robmacl/breathecam/Parts Lists/Arecont/benedum mount.xlsx

1 | 89015K243 (http://www.mcmaster.com/nav/enter.asp?partnum=89015K243) | Multipurpose 6061 Aluminum, Sheet, .125" Thick, 18" X 18" | 1 | 1 | 0 | 56.67 | 56.67
 |  |  | Each |  |  | Each
2 | 8975K142 (http://www.mcmaster.com/nav/enter.asp?partnum=8975K142) | Multipurpose 6061 Aluminum, 1/4" Thick, 12" X 12" | 1 | 1 | 0 | 30.39 | 30.39
 |  |  | Each |  |  | Each
3 | 8982K14 (http://www.mcmaster.com/nav/enter.asp?partnum=8982K14) | Multipurpose 6061 Aluminum, 90 Degree Angle, 1/8" Thick, 2" X 2" Legs, 1' Long | 1 | 1 | 0 | 6.17 | 6.17
 |  |  | Each |  |  | Each
4 | 93190A546 (http://www.mcmaster.com/nav/enter.asp?partnum=93190A546) | Type 316 Stainless Steel Hex Head Cap Screw, 1/4"-20 Thread, 1-1/2" Long, Fully Threaded, Packs of 10 | 1 | 1 | 0 | 5.27 | 5.27
 |  |  | Pack |  |  | Per Pack
5 | 91831A029 (http://www.mcmaster.com/nav/enter.asp?partnum=91831A029) | 18-8 Stainless Steel Nylon-Insert Hex Locknut, 1/4"-20 Thread Size, 7/16" Width, 5/16" Height, Packs of 50 | 1 | 1 | 0 | 4.3 | 4.3
 |  |  | Pack |  |  | Per Pack
6 | 92141A029 (http://www.mcmaster.com/nav/enter.asp?partnum=92141A029) | 18-8 Stainless Steel General Purpose Flat Washer, 1/4" Screw Size, 5/8" OD, .04"-.06" Thick, Packs of 100 | 1 | 1 | 0 | 3.37 | 3.37
 |  |  | Pack |  |  | Per Pack
7 | 97517A330 (http://www.mcmaster.com/nav/enter.asp?partnum=97517A330) | Aluminum Blind Rivet with Steel Mandrel, Wide Domed, 3/16" Diameter, .251"-.375" Material Thickness, Packs of 100 | 1 | 1 | 0 | 7.38 | 7.38
 |  |  | Pack |  |  | Per Pack
8 | 7649K52 (http://www.mcmaster.com/nav/enter.asp?partnum=7649K52) | Rain-Tight Outdoor Steel Enclosure (NEMA 3R), with Knockouts and Lift-Off Cover, 8" H, 8" W, 4" D | 1 | 1 | 0 | 28.62 | 28.62
 |  |  | Each |  |  | Each
9 | 7609K4 (http://www.mcmaster.com/nav/enter.asp?partnum=7609K4) | Liquid-Tight Ultra-Flex Plastic Conduit, 3/4 Trade Size, 0.83" ID, 1.04" OD, 5' Length | 5 | 5 | 0 | 2.23 | 11.15
 |  |  | Feet |  |  | Per Foot
10 | 88805K77 (http://www.mcmaster.com/nav/enter.asp?partnum=88805K77) | Highly Corrosion-Resistant 6063 Aluminum, 90 Degree Angle, 1/8" Thick, 1" X 1" Legs, 4' Long | 1 | 1 | 0 | 12.21 | 12.21
 |  |  | Each |  |  | Each
11 | 8975K578 (http://www.mcmaster.com/nav/enter.asp?partnum=8975K578) | Multipurpose 6061 Aluminum, Rectangular Bar, 1/8" X 1", 1/2' Long | 4 | 4 | 0 | 0.91 | 3.64
 |  |  | Each |  |  | Each
12 | 71695K21 (http://www.mcmaster.com/nav/enter.asp?partnum=71695K21) | Steel Switch Box, 2-1/8" X 4" X 1-7/8" | 1 | 1 | 0 | 1.86 | 1.86
 |  |  | Each |  |  | Each
13 | 71695K23 (http://www.mcmaster.com/nav/enter.asp?partnum=71695K23) | Duplex Receptacle Cover for Switch Box, Steel | 1 | 1 | 0 | 0.68 | 0.68
 |  |  | Each |  |  | Each
14 | 7159K3 (http://www.mcmaster.com/nav/enter.asp?partnum=7159K3) | Straight-Blade Receptacle, Economy, NEMA 5-15, Gray | 1 | 1 | 0 | 2.13 | 2.13
 |  |  | Each |  |  | Each
15 | 7798K41 (http://www.mcmaster.com/nav/enter.asp?partnum=7798K41) | Cord Grip for Building Cable, Screw Connector Style, 1/2 Trade Size | 1 | 1 | 0 | 0.98 | 0.98
 |  |  | Each |  |  | Each
16 | 29115A724 (http://www.mcmaster.com/nav/enter.asp?partnum=29115A724) | Long-Life Tin-Coated High-Speed-Steel Jobbers' Drill Bit, 1/4", 4" L Overall, 2.4" Drill Depth, 135 Degree Point | 1 | 1 | 0 | 4.95 | 4.95
 |  |  | Each |  |  | Each
 | Adafruit
1 x Cable Gland - Waterproof RJ-45 / Ethernet connector (RJ-45) [ID:827] =
$7.95
