robmacl/breathecam/Parts Lists/Arecont/TimeMachineIPMount.xlsx

1 | 92210A546 (http://www.mcmaster.com/nav/enter.asp?partnum=92210A546) | 18-8 Stainless Steel Flat Head Socket Cap Screw, 1/4"-20 Thread, 1-1/2" Long, packs of 25 | 2 | today | 7.04 | 14.08
 |  |  | packs |  | per pack
2 | 91831A029 (http://www.mcmaster.com/nav/enter.asp?partnum=91831A029) | 18-8 Stainless Steel Nylon-Insert Hex Locknut, 1/4"-20 Thread Size, 7/16" Width, 5/16" Height, packs of 50 | 1 | today | 5.01 | 5.01
 |  |  | pack |  | per pack
3 | 95584A207 (http://www.mcmaster.com/nav/enter.asp?partnum=95584A207) | 18-8 Stainless Steel External-Tooth Lock Washer, 1/4" Screw Size, 0.51" OD, 0.02"-0.03" Thick, packs of 100 | 1 | today | 3.88 | 3.88
 |  |  | pack |  | per pack
4 | 95584A205 (http://www.mcmaster.com/nav/enter.asp?partnum=95584A205) | 18-8 Stainless Steel External-Tooth Lock Washer, No. 10 Screw Size, 0.41" OD, 0.01"-0.03" Thick, packs of 100 | 1 | today | 2.77 | 2.77
 |  |  | pack |  | per pack
5 | 91772A247 (http://www.mcmaster.com/nav/enter.asp?partnum=91772A247) | 18-8 Stainless Steel Pan Head Phillips Machine Screw, 10-24 Thread, 1" Length, packs of 50 | 1 | today | 7.28 | 7.28
 |  |  | pack |  | per pack
6 | 91831A011 (http://www.mcmaster.com/nav/enter.asp?partnum=91831A011) | 18-8 Stainless Steel Nylon-Insert Hex Locknut, 10-24 Thread Size, 3/8" Width, 15/64" Height, packs of 100 | 1 | today | 6.54 | 6.54
 |  |  | pack |  | per pack
7 | 96659A104 (http://www.mcmaster.com/nav/enter.asp?partnum=96659A104) | 18-8 Stainless Steel Type A SAE Flat Washer, No. 10 Screw Size, 1/2" OD, .03"-.07" Thick, packs of 100 | 1 | today | 4.48 | 4.48
 |  |  | pack |  | per pack
8 | 2742A514 (http://www.mcmaster.com/nav/enter.asp?partnum=2742A514) | Countersink for Aluminum, Brass, and Bronze, 3-Flute, 82 Degree Angle, 5/8" Body Diameter, 1/4" Shank Diameter | 1 | today | 21.32 | 21.32
 |  |  | each |  | each
9 | 7438K32 (http://www.mcmaster.com/nav/enter.asp?partnum=7438K32) | Outdoor Extension Cord, 16 Gauge Wire, Orange, 25' Long | 1 | today | 13.24 | 13.24
 |  |  | each |  | each
10 | 69915K53 (http://www.mcmaster.com/nav/enter.asp?partnum=69915K53) | Nylon Liquid-Tight Cord Grip (NEMA 6), Straight Standard, 1/2" NPT, .24"-.47" Cord Diameter | 2 | today | 3.24 | 6.48
 |  |  | each |  | each
11 | 69915K54 (http://www.mcmaster.com/nav/enter.asp?partnum=69915K54) | Nylon Liquid-Tight Cord Grip (NEMA 6), Straight Standard, 1/2" NPT, .20"-.35" Cord Diameter | 2 | today | 3.24 | 6.48
 |  |  | each |  | each
12 | 69915K57 (http://www.mcmaster.com/nav/enter.asp?partnum=69915K57) | Nylon Liquid-Tight Cord Grip (NEMA 6), Straight Standard, 1/2" NPT, .39"-.56" Cord Diameter | 2 | today | 3.46 | 6.92
 |  |  | each |  | each
13 | 7160K73 (http://www.mcmaster.com/nav/enter.asp?partnum=7160K73) | GFCI Receptacle, Box Mount, NEMA 5-15, White | 1 | today | 15.04 | 15.04
 |  |  | each |  | each
14 | 2779K12 (http://www.mcmaster.com/nav/enter.asp?partnum=2779K12) | LED Panel Mount Indicating Light, 8MM, 12V AC/DC, Sunlight Visible/Waterproof, Green | 1 | today | 14.52 | 14.52
 |  |  | each |  | each
15 | 2779K802 (http://www.mcmaster.com/nav/enter.asp?partnum=2779K802) | Push-on Black Connector Lead for, LED Panel Mount Indicating Light | 1 | today | 2.76 | 2.76
 |  |  | each |  | each
16 | 2779K801 (http://www.mcmaster.com/nav/enter.asp?partnum=2779K801) | Push-on Red Connector Lead for, LED Panel Mount Indicating Light | 1 | today | 2.76 | 2.76
 |  |  | each |  | each
17 | 7280K11 (http://www.mcmaster.com/nav/enter.asp?partnum=7280K11) | NPT Threaded Aluminum Hole Plug, 1/2" Thread Size, 3/4" Head Diameter | 5 | today | 2.33 | 11.65
 |  |  | each |  | each
18 | 7566K35 (http://www.mcmaster.com/nav/enter.asp?partnum=7566K35) | Cable Tie Holder, Screw Mount, 4-Way Compact, .18" W Max Tie, #10 Screw Size, packs of 100 | 1 | today | 12.46 | 12.46
 |  |  | pack |  | per pack
19 | 99604A107 (http://www.mcmaster.com/nav/enter.asp?partnum=99604A107) | Silicone Sealing Washer, No. 10 Screw Size, 1/2" OD, .093" Thick, packs of 50 | 1 | today | 9.31 | 9.31
 |  |  | pack |  | per pack
20 | 8104K111 (http://www.mcmaster.com/nav/enter.asp?partnum=8104K111) | Lamp Cable, 18/2 AWG, 0.11" X 0.21" OD, 300 VAC, Black | 20 | today | 0.25 | 5
 |  |  | feet |  | per foot
21 | 7527K42 (http://www.mcmaster.com/nav/enter.asp?partnum=7527K42) | 300 VAC/VDC Terminal Block, 2 Circuits, 3/8" Center-to-Center, 20 Amps | 1 | today | 1.32 | 1.32
 |  |  | each |  | each
22 | 81905K11 (http://www.mcmaster.com/nav/enter.asp?partnum=81905K11) | Pluggable Touch-Safe Terminal Block, Plug, 2 Circuits | 1 | today | 1.18 | 1.18
 |  |  | each |  | each
23 | 81905K21 (http://www.mcmaster.com/nav/enter.asp?partnum=81905K21) | Pluggable Touch-Safe Terminal Block, Receptacle, 2 Circuits | 1 | today | 1.07 | 1.07
 |  |  | each |  | each
24 | 7219K22 (http://www.mcmaster.com/nav/enter.asp?partnum=7219K22) | Aluminum Weatherproof Box, Single Device (1 Gang), Three 1/2 Trade Size Hubs, 2" D | 1 | today | 4.17 | 4.17
 |  |  | each |  | each
25 | 7526K25 (http://www.mcmaster.com/nav/enter.asp?partnum=7526K25) | Nylon Wall Plate, 1 GFCI Receptacle, 2-15/16" W X 4-11/16" H, White | 1 | today
 |  |  | each
 |  | 12v adapter | http://www.amazon.com/dp/B00DGG7E36/ref=pe_385040_30332200_pe_309540_26725410_item
 |  | pelican case | http://www.amazon.com/dp/B0000DYVAV/ref=pe_385040_30332200_pe_309540_26725410_item
 |  | ethernet cable | http://www.amazon.com/dp/B001TH7GVE/ref=pe_385040_30332200_pe_309540_26725410_item
 |  | tripod mount | http://www.bhphotovideo.com/c/product/554165-REG/Manfrotto_410PL_410PL_Quick_Release_Plate.html
1 | 7587A37 (http://www.mcmaster.com/nav/enter.asp?partnum=7587A37) | Dow Corning Silicone Adhesive/Sealant, 732, 3.0 Ounce Tube, Clear | 2 | 2 | 0 | 3.95 | 7.9
 |  |  | Each |  |  | Each
2 | 7219K13 (http://www.mcmaster.com/nav/enter.asp?partnum=7219K13) | Round, Vertical/Horizontal 1 Hole Cover for, Aluminum Weatherproof Box | 2 | 2 | 0 | 2.89 | 5.78
 |  |  | Each |  |  | Each
3 | 7581K42 (http://www.mcmaster.com/nav/enter.asp?partnum=7581K42) | Super Tough Liquid-Tight PVC Conduit, 1/2" Trade Size, 0.63" ID, 0.83" OD, 10' Length | 10 | 10 | 0 | 1.13 | 11.3
 |  |  | Feet |  |  | Per Foot
4 | 9106K42 (http://www.mcmaster.com/nav/enter.asp?partnum=9106K42) | Liquid-Tight Nonmetallic Conduit Fitting, Twist-in Straight, PVC, 1/2" Trade Size, Black | 2 | 2 | 0 | 1.6 | 3.2
 |  |  | Each |  |  | Each
5 | 9106K88 (http://www.mcmaster.com/nav/enter.asp?partnum=9106K88) | Liquid-Tight Nonmetallic Conduit Fitting, Twist-in Coupling, PVC, 1/2" Trade Size | 2 | 2 | 0 | 1.34 | 2.68
 |  |  | Each |  |  | Each
1 | 9246K21 (http://www.mcmaster.com/nav/enter.asp?partnum=9246K21) | Multipurpose Aluminum (Alloy 6061), 3/8" Thick, 8" X 8" | 2 | 2 | 0 | 21.05 | 42.1
 |  |  | Each |  |  | Each
2 | 6546K342 (http://www.mcmaster.com/nav/enter.asp?partnum=6546K342) | Multipurpose Aluminum (Alloy 6061) Rectangle Tube, 3/16" Wall Thickness, 1" X 1", 3' Length | 2 | 2 | 0 | 18.73 | 37.46
 |  |  | Each |  |  | Each
3 | 8975K17 (http://www.mcmaster.com/nav/enter.asp?partnum=8975K17) | Multipurpose Aluminum (Alloy 6061), 1/8" Thick X 1" Width X 6' Length | 1 | 1 | 0 | 6.53 | 6.53
 |  |  | Each |  |  | Each
4 | 7219K7 (http://www.mcmaster.com/nav/enter.asp?partnum=7219K7) | Aluminum Weatherproof Box, Round, Five 1/2 Trade Size Hubs, 1-9/16" DP. | 1 | 1 | 0 | 6.5 | 6.5
 |  |  | Each |  |  | Each
5 | 7219K71 (http://www.mcmaster.com/nav/enter.asp?partnum=7219K71) | Aluminum Weatherproof Box, Round, Five 3/4 Trade Size Hubs, 1-9/16" DP | 1 | 1 | 0 | 8.58 | 8.58
 |  |  | Each |  |  | Each
6 | 7807K33 (http://www.mcmaster.com/nav/enter.asp?partnum=7807K33) | Multicord Nylon Liquid-Tight Cord Grip, 1/2" NPT, for 2 Cords, 0.16"-0.20" Cord Diameter Range | 1 | 1 | 0 | 4.33 | 4.33
 |  |  | Each |  |  | Each
7 | 69915K54 (http://www.mcmaster.com/nav/enter.asp?partnum=69915K54) | Nylon Liquid-Tight Cord Grip (NEMA 6), Straight Standard, 1/2" NPT, .20"-.35" Cord Diameter | 2 | 2 | 0 | 3.24 | 6.48
 |  |  | Each |  |  | Each
 |  | poe adapter | http://www.amazon.com/dp/B004UBUB7C/ref=pe_385040_30332200_pe_309540_26725410_item
 | 191772A196 | 18-8 Stainless Steel Pan Head Phillips Machine Screw, 8-32 Thread, 5/8" Length, packs of 1001
 | 95584A203 | 18-8 Stainless Steel External-Tooth Lock Washer, No. 8 Screw Size, 0.39" OD, 0.01"-0.03" Thick, packs of 1001
 | 1810A31 | Loctite General Anaerobic Adhesive, Threadlocker 220, 0.34 Ounce, 10 ml Bottle1
 | 2198A86 | Glass Surface-Mount Bull's Eye Level, with 2 Centering Circles, 1-7/16" Base Diameter1
 | 7219K25 | Aluminum Weatherproof Box, Two Device (2 Gang), Three 1/2 Trade Size Hubs, 2" D1
 | 69105K67 | Straight-Blade Receptacle, Flush-Mount, NEMA 5-15, White1
 | 7533K84 | Wall Plate, Stainless Steel, 2 GFCI Receptacles, 4-9/16" W X 4-1/2" H1
 |  | tripod | http://www.amazon.com/gp/product/B001B2I9L8/ref=ox_ya_os_product
 |  | tripod head | http://www.amazon.com/gp/product/B000H0338Y/ref=ox_ya_os_product
