robmacl/breathecam/Parts Lists/Arecont/trimont parts.xlsx

18"x18"x0.25" aluminum plate | 1 | 89155K27
u-bolts | 4 | 8896T26
nuts for u-bolts | 4 | 91831A127
rubber padding for u-bolts | 3 | 2614T74
washers for u-bolts | 1 | 93852A104
airport express | 1 | http://www.amazon.com/gp/product/B008ALA2RC/ref=ox_sc_act_title_1?ie=UTF8&psc=1&smid=ATVPDKIKX0DER
airport express bracket | 1 | http://www.amazon.com/Out-Sight-Bracket-White--AirPort-Express/dp/B009MRBKXS?s=electronics
3v power cupply | 1 | 102-3199-ND
12v power supply | 1 | 603-1237-ND
relay module | 1 | http://www.amazon.com/gp/product/B0057OC5O8/ref=oh_details_o00_s00_i00?ie=UTF8&psc=1
ethernet arduino | 1 | https://www.sparkfun.com/products/11229
external temperautre sensor | 1 | https://www.sparkfun.com/products/11931
protoshield | 1 | https://www.sparkfun.com/products/9729
on board temperautre | 1 | https://www.sparkfun.com/products/10988
peltier heat pump | 1 | http://www.allelectronics.com/make-a-store/item/PJT-10/LARGE-THERMOELECTRIC-DEVICE/1.html
extension cord |  | 7438K32 (http://www.mcmaster.com/)
outlet cover |  | http://www.amazon.com/MM710C-Weatherproof-Outdoor-Receptacle-Protector/dp/B0013FRYH8
12"x24" aluminum for enclosure | x | 8975K142 (http://www.mcmaster.com/)
enclosure | x | 7335K23
panel for enclosure | x | 7335K43 (http://www.mcmaster.com/)
1" wide bar for straping bar to post | x | 8975K596 (http://www.mcmaster.com/)
bolts for straping enclosure to post | x | 91771A571
fan | 2 | 603-1364-ND
5v power supply |  | 102-3200-ND
din rail |  | ADR3575-S0300-ND
conduit | 10' | 7609K4
conduit fittings |  | 75145K33 (http://www.mcmaster.com/)
90 degree conduit fitting |  | 75145K83 (http://www.mcmaster.com/)
5' ethernet cable
7' ethernet cable
bolts for enclosure |  | 96755A329 (http://www.mcmaster.com/)
cord grip for power |  | 69915K53 (http://www.mcmaster.com/)
silicon sealent |  | 7545A451 (http://www.mcmaster.com/)
1-1/4" 6-32 standoffs |  | 91115A560 (http://www.mcmaster.com/nav/enter.asp?partnum=91115A560)
1-3/8" 6-32 machine screws |  | 91772A156 (http://www.mcmaster.com/nav/enter.asp?partnum=91772A156)
outside fan |  | AQ1212LB-A71GL-LF
