robmacl/breathecam/Parts Lists/Nikon/nikon_PowerBoardV4Parts_BOM.xlsx

Quantity | Reference | Part | Part Number | Distributor | Manufacturer part number
1 | U2 | Microcontroller | ATXMEGA32A4-AU-ND | Digikey | ATXMEGA32A4-AU
1 | U1 | TC1262-3.0v | TC1262-3.0VDB-ND | Digikey | TC1262-3.0VDB
1 | U3 | FT232R | 768-1007-1-ND | Digikey | FT232RL-REEL
1 | U4 | MCP3202 | MCP3202-CI/SN-ND | Digikey | MCP3202-CI/SN
2 | U6, U7 | 5v supply | 1470-1115-ND | Digikey | ECE10US05
1 | U5 | 9v supply | 1470-1134-ND | Digikey | ECE40US09
2 | Q1, Q2 | 425-2098-1-ND | optocoupler | Digikey | PC365NJ0000F
2 | K1, K2 | Z112CT-ND | relay | Digikey | G6K-2F-TR DC5
5 | LED1, LED2, LED3, LED4, LED5 | 160-1435-1-ND | green leds 0603 | Digikey | LTST-C190KGKT
2 | D1, D2 | B260A-FDICT-ND | diode for relay | Digikey | B260A-13-F
3 | F1, F2, F3 | WK0001-ND | fuse holder | Digikey | 56000001319
2 | J1, J2 | APC1259-ND | 3-pin screw terminal | Digikey | ELFH03210
1 | J5 | 609-3907-ND | screw terminal header | Digikey | 20020110-H021A01LF
2 | J7, J8 | 609-4618-1-ND | usb - micro | Digikey | 10118194-0001LF
2 | J3, J4 | 1175-1015-ND | usb - A | Digikey | 1002-001-01000
1 | J9 | 952-2121-ND | isp header | Digikey | M20-9980346
1 | J6 | 609-3461-ND | 3-pin header | Digikey | 68000-103HLF
4 | R1, R3, R4, R5 | 311-330HRCT-ND | 330R 0603 resistor | Digikey | RC0603FR-07330RL
2 | R8, R9 | 311-470GRCT-ND | 470R 0603 resistor | Digikey | RC0603JR-07470RL
1 | R6 | 311-1.0KGRCT-ND | 1k 0603 resistor | Digikey | RC0603JR-071KL
1 | R2 | P10KGCT-ND | 10k 0603 resistor | Digikey | ERJ-3GEYJ103V
1 | R7 | CRL1206-FW-R200ELFCT-ND | 0.2R 1206 resistor | Digikey | CRL1206-FW-R200ELF
1 | R10 | A121216CT-ND | 300R 2512 resistor | Digikey | 3522300RFT
7 | C5, C6, C7, C8, C9, C11, C12 | 490-1575-1-ND | 0.1uF 0603 ceramic capacitor | Digikey | GRM188F51E104ZA01D
2 | C1, C2 | 399-3678-1-ND | 1uf 1206 tantalum capacitor | Digikey | T491A105K016AT
4 | C3, C4, C10, C13 | 495-2174-1-ND | 10uf 1206 tantalum capacitor | Digikey | T491A106M004AT
1 | C14 | 1276-1312-1-ND | 10uF 1206 cermic capacitor | Digikey | CL31F106ZOHNNNE
