robmacl/breathecam/CAD/pi_cam/fan_assy.SLDASM

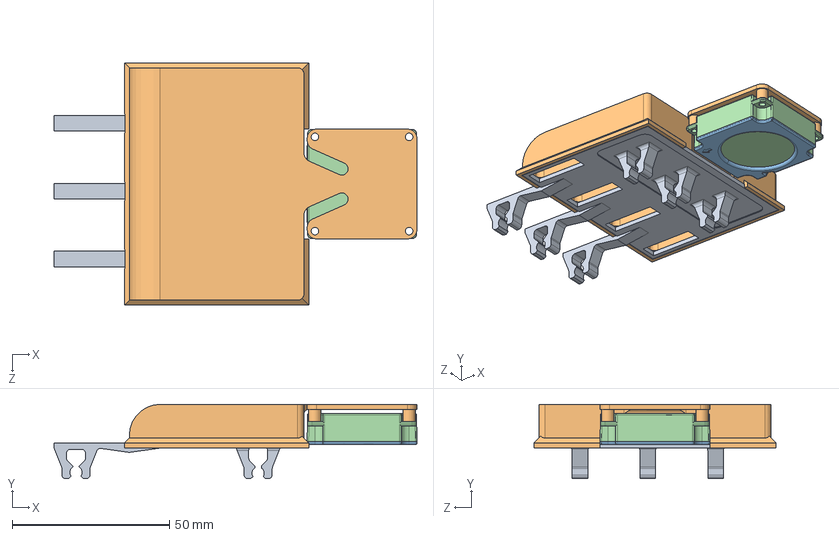
[picture p1: CAD file, 2022-07-15]
CAD/pi_cam/fan_assy.SLDASM
115.6 x 23.6 x 77.2 mm
air_box
air_top
410020620000_2.stp
3_5CM-FRAME_BEFORE__AF1.stp
