robmacl/breathecam/CAD/nikon/servo.SLDASM

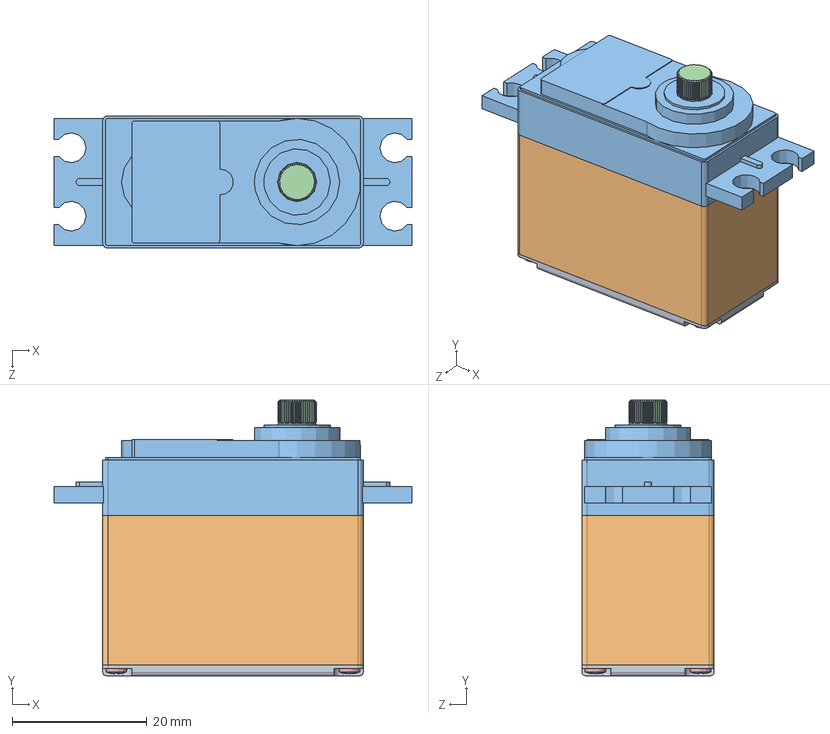
[picture p3: CAD file, 2022-03-16]
CAD/nikon/servo.SLDASM
53.2 x 41.0 x 19.7 mm
bottom cover
servo Case
servo cover
spline output
long screw x 4
