robmacl/breathecam/CAD/nikon/Assem_j5.SLDASM

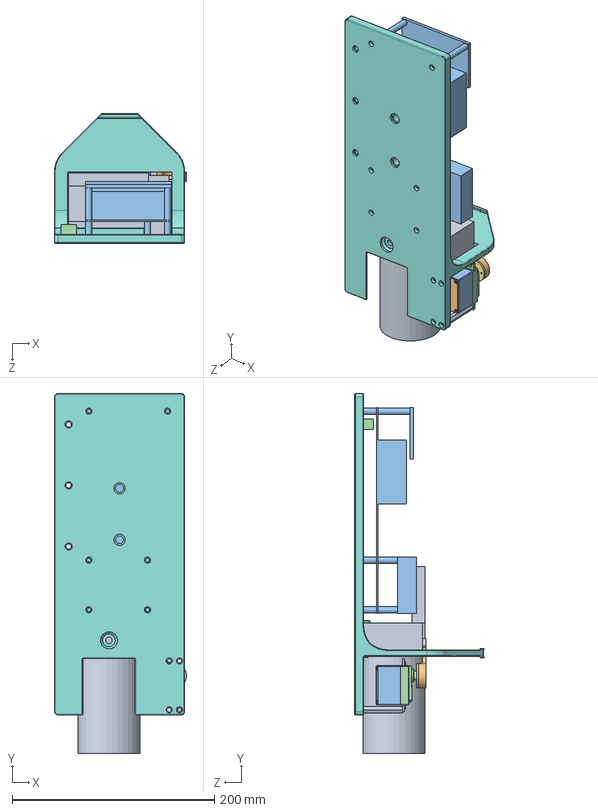
[picture p4: CAD file, 2022-03-16]
CAD/nikon/Assem_j5.SLDASM
130.4 x 355.6 x 128.0 mm
camera J5
bottom cover
servo Case
servo cover
spline output
long screw x 4
HMSH-01
j5 base
standoff_1.5x0.25
J5 button pusher V25
board_v4
tie down
