robmacl/breathecam/CAD/nikon/Assem1.SLDASM

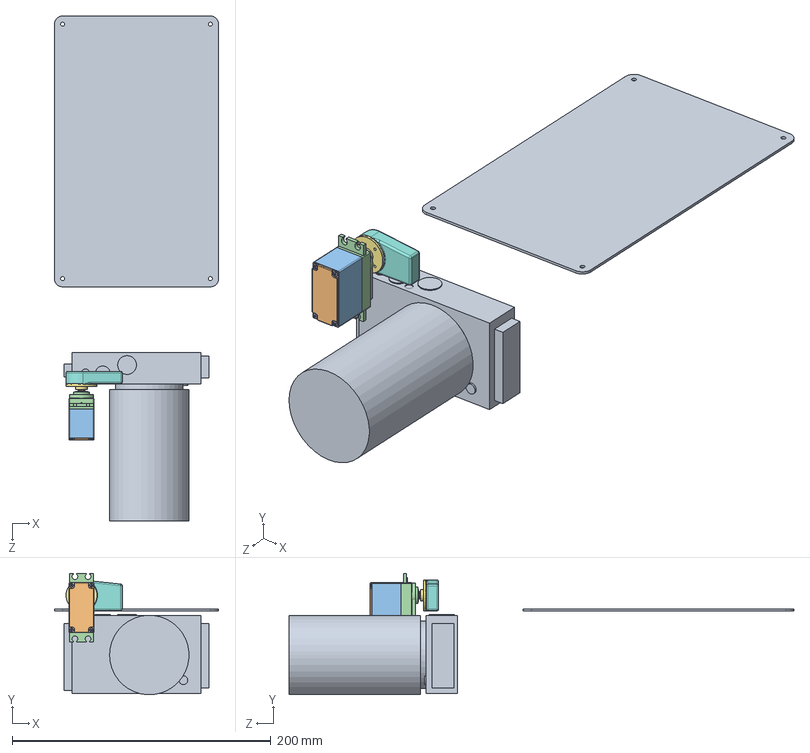
[picture p5: CAD file, 2022-03-16]
CAD/nikon/Assem1.SLDASM
127.0 x 93.9 x 390.7 mm
camera
bottom cover
servo Case
servo cover
spline output
long screw x 4
HMSH-01
ac cover
