robmacl/breathecam/CAD/nikon/spring_return_v2.SLDPRT

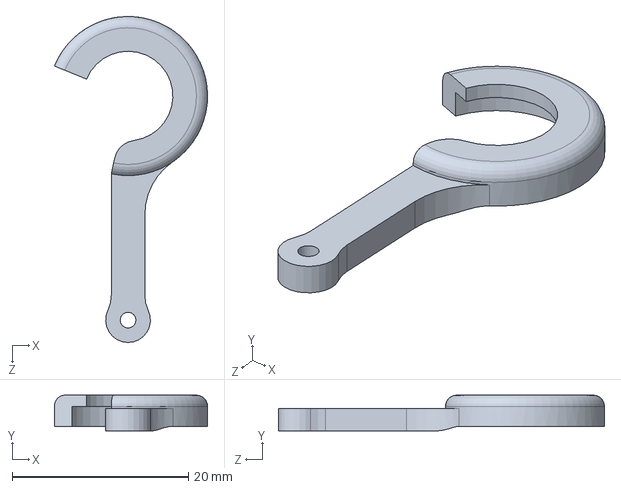
[picture p6: CAD file, 2022-03-16]
CAD/nikon/spring_return_v2.SLDPRT
17.4 x 4.06 x 37.0 mm
