robmacl/breathecam/CAD/pi_cam/camera_mount.SLDPRT

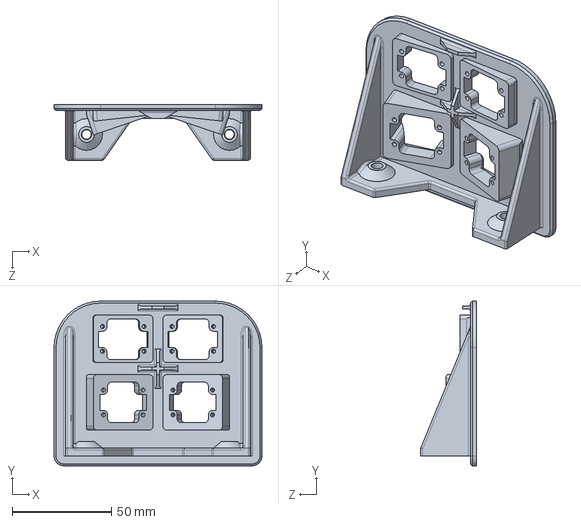
[picture p7: CAD file, 2022-07-26]
CAD/pi_cam/camera_mount.SLDPRT
104.8 x 83.0 x 28.0 mm
