robmacl/breathecam/CAD/nikon/j5 base v3.SLDPRT

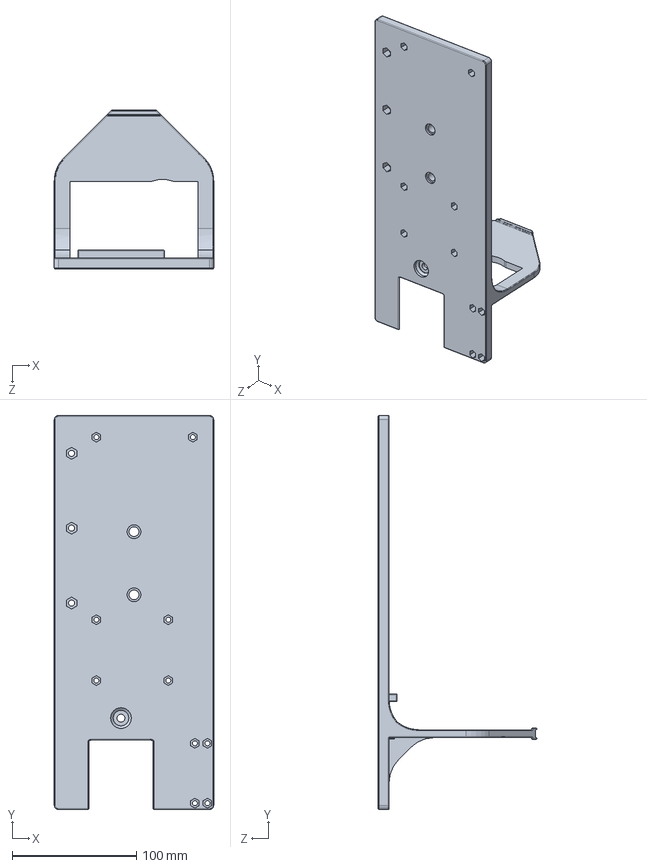
[picture p8: CAD file, 2022-03-16]
CAD/nikon/j5 base v3.SLDPRT
128.6 x 317.5 x 128.0 mm
