robmacl/breathecam/CAD/pi_cam/power_mount.SLDPRT

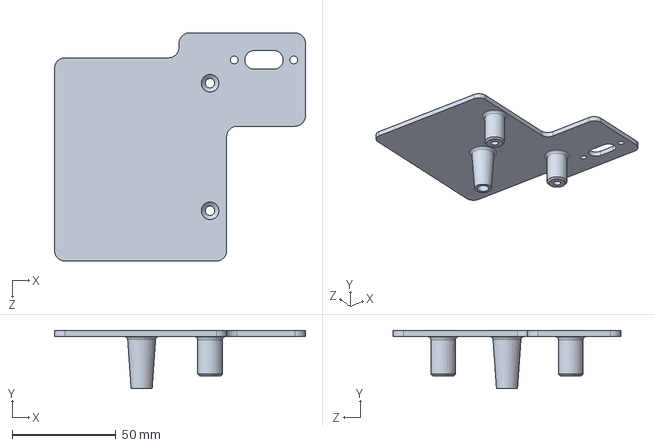
[picture p9: CAD file, 2022-07-26]
CAD/pi_cam/power_mount.SLDPRT
121.0 x 28.0 x 110.0 mm
