robmacl/breathecam/CAD/nikon/servo Case.SLDPRT

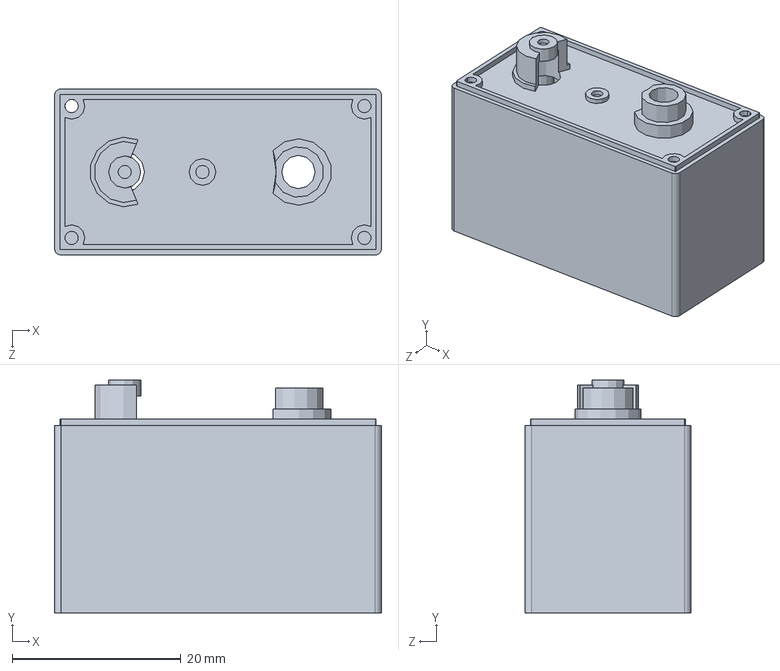
[picture p10: CAD file, 2022-03-16]
CAD/nikon/servo Case.SLDPRT
38.7 x 27.6 x 19.7 mm
