robmacl/breathecam/CAD/pi_cam/mount_plate_4pi.SLDPRT

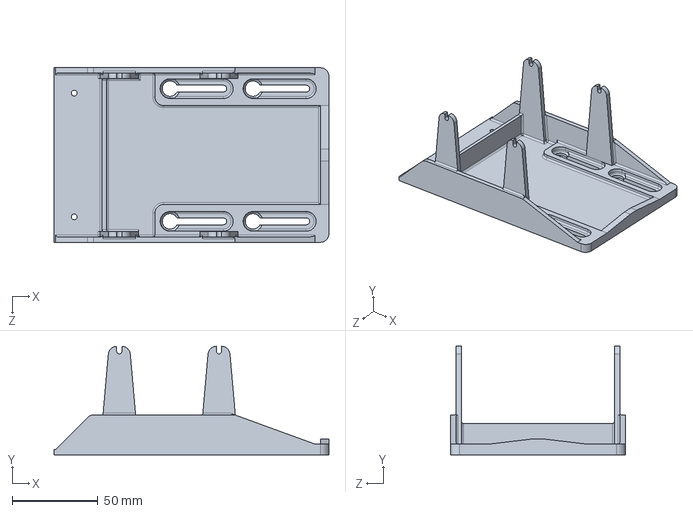
[picture p11: CAD file, 2022-07-18]
CAD/pi_cam/mount_plate_4pi.SLDPRT
160.0 x 63.2 x 101.6 mm
