robmacl/breathecam/CAD/pi_cam/air_box.SLDPRT

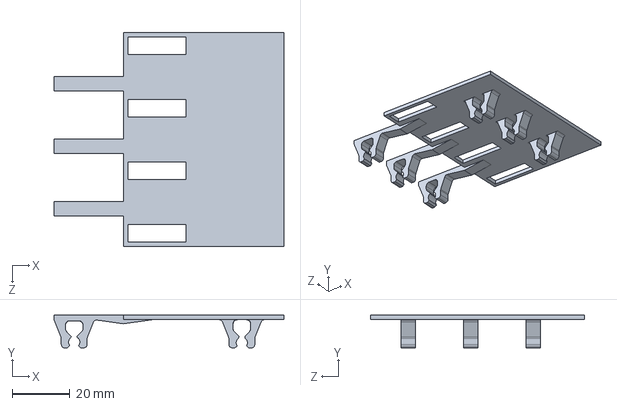
[picture p12: CAD file, 2022-07-15]
CAD/pi_cam/air_box.SLDPRT
79.6 x 11.4 x 74.0 mm
