robmacl/breathecam/CAD/pi_cam/dummy_parts/m25_clamp_rod.SLDPRT

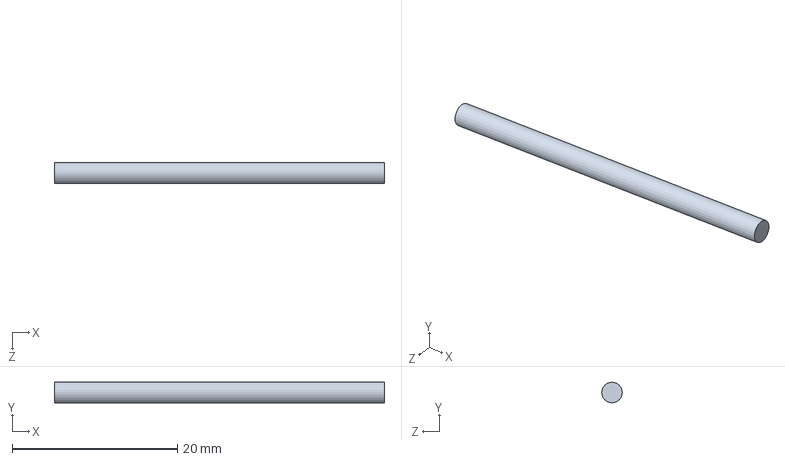
[picture p13: CAD file, 2022-06-27]
CAD/pi_cam/dummy_parts/m25_clamp_rod.SLDPRT
40.0 x 2.50 x 2.50 mm
