robmacl/breathecam/CAD/pi_cam/air_top.SLDPRT

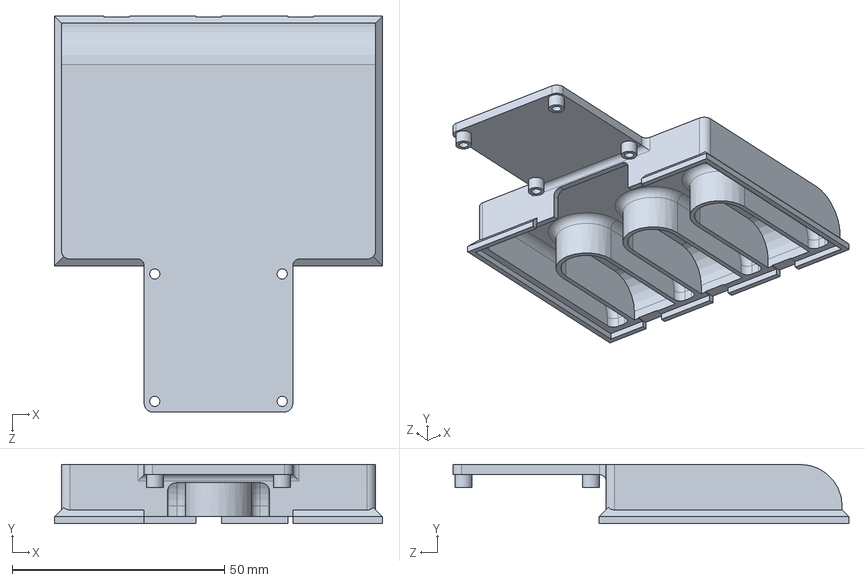
[picture p14: CAD file, 2022-07-15]
CAD/pi_cam/air_top.SLDPRT
77.2 x 13.9 x 93.2 mm
