robmacl/breathecam/CAD/pi_cam/dummy_parts/m25_long_rod.SLDPRT

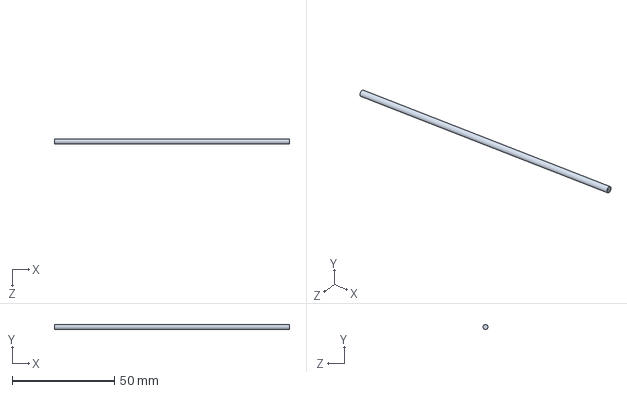
[picture p15: CAD file, 2022-06-27]
CAD/pi_cam/dummy_parts/m25_long_rod.SLDPRT
115.0 x 2.50 x 2.50 mm
