robmacl/breathecam/CAD/nikon/camera J5.SLDPRT

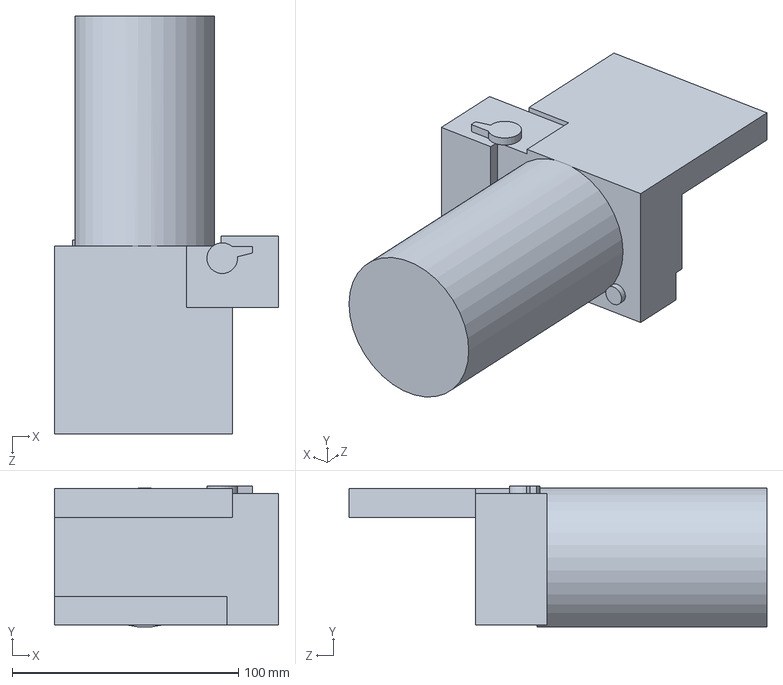
[picture p16: CAD file, 2022-03-16]
CAD/nikon/camera J5.SLDPRT
99.1 x 62.3 x 184.8 mm
