robmacl/breathecam/CAD/nikon/ac cover j5.SLDPRT

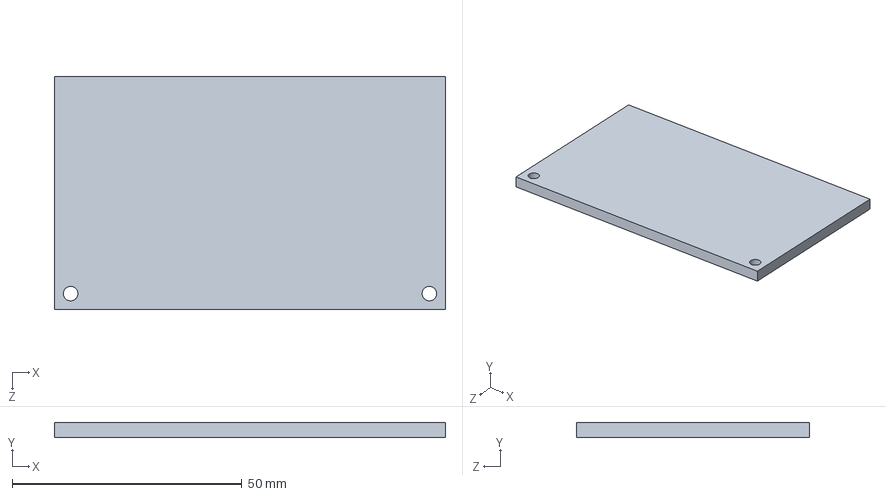
[picture p17: CAD file, 2022-03-16]
CAD/nikon/ac cover j5.SLDPRT
85.1 x 3.17 x 50.8 mm
