robmacl/breathecam/CAD/pi_cam/retainer_clamp_4pii.SLDPRT

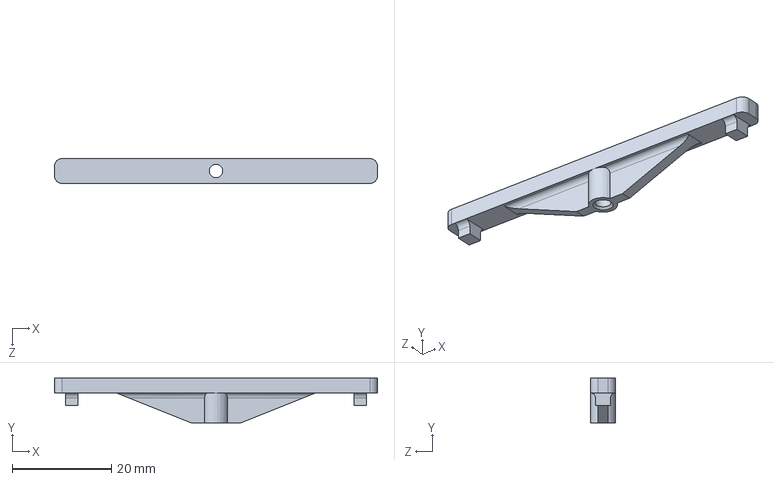
[picture p18: CAD file, 2022-07-11]
CAD/pi_cam/retainer_clamp_4pii.SLDPRT
65.0 x 9.00 x 5.00 mm
