robmacl/breathecam/CAD/nikon/cover.SLDPRT

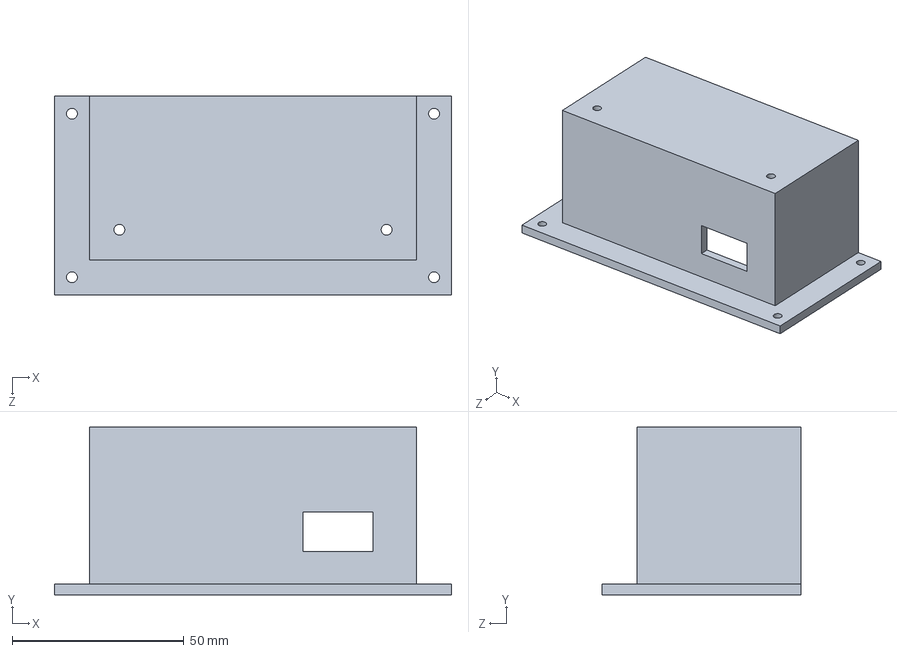
[picture p19: CAD file, 2022-03-16]
CAD/nikon/cover.SLDPRT
115.6 x 48.9 x 57.8 mm
