robmacl/breathecam/CAD/pi_cam/insert_test.SLDPRT

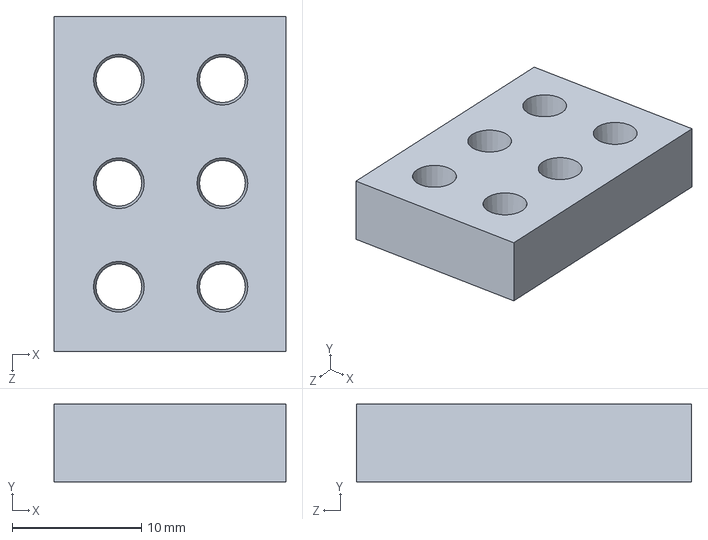
[picture p20: CAD file, 2022-04-14]
CAD/pi_cam/insert_test.SLDPRT
17.9 x 6.00 x 25.9 mm
