robmacl/breathecam/CAD/nikon/j5 horn v2.STL

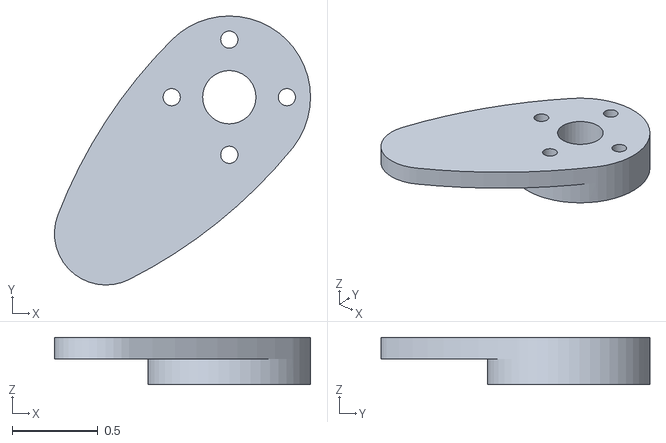
[picture p21: CAD file, 2022-03-16]
CAD/nikon/j5 horn v2.STL
1.49 x 1.56 x 0.275
