robmacl/breathecam/CAD/pi_cam/dummy_parts/anker_atom_slim.SLDPRT

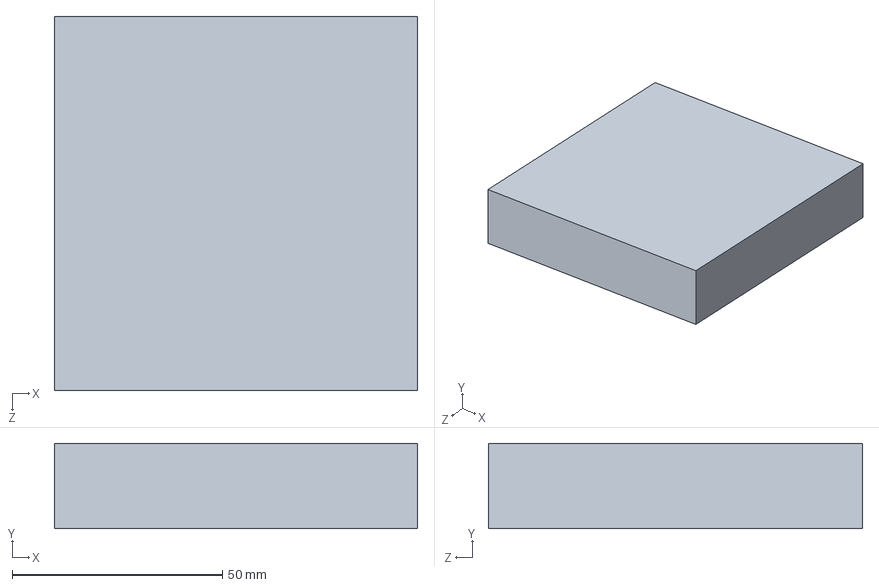
[picture p22: CAD file, 2022-06-23]
CAD/pi_cam/dummy_parts/anker_atom_slim.SLDPRT
86.4 x 20.3 x 88.9 mm
