robmacl/breathecam/CAD/pi_cam/mount_plate.SLDPRT

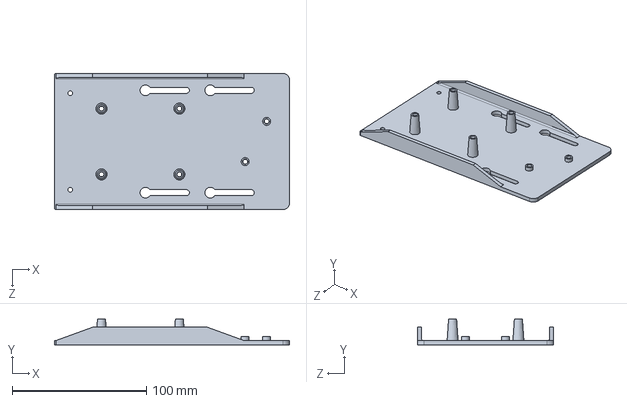
[picture p23: CAD file, 2022-04-14]
CAD/pi_cam/mount_plate.SLDPRT
175.0 x 19.2 x 101.6 mm
