robmacl/breathecam/CAD/nikon/ac cover.SLDPRT

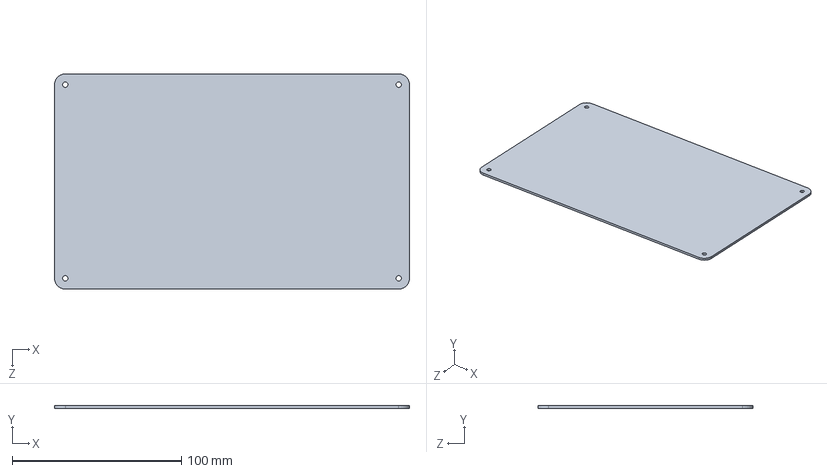
[picture p24: CAD file, 2022-03-16]
CAD/nikon/ac cover.SLDPRT
209.5 x 1.59 x 127.0 mm
