robmacl/breathecam/CAD/pi_cam/drill_test.SLDPRT

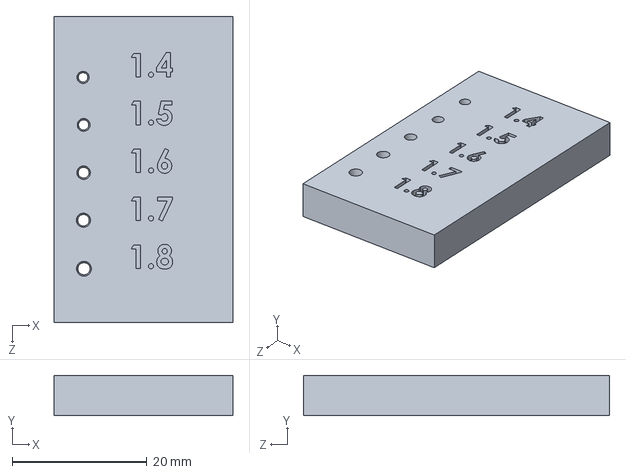
[picture p25: CAD file, 2022-04-09]
CAD/pi_cam/drill_test.SLDPRT
26.5 x 6.00 x 45.3 mm
