robmacl/breathecam/CAD/pi_cam/angle_bracket.SLDPRT

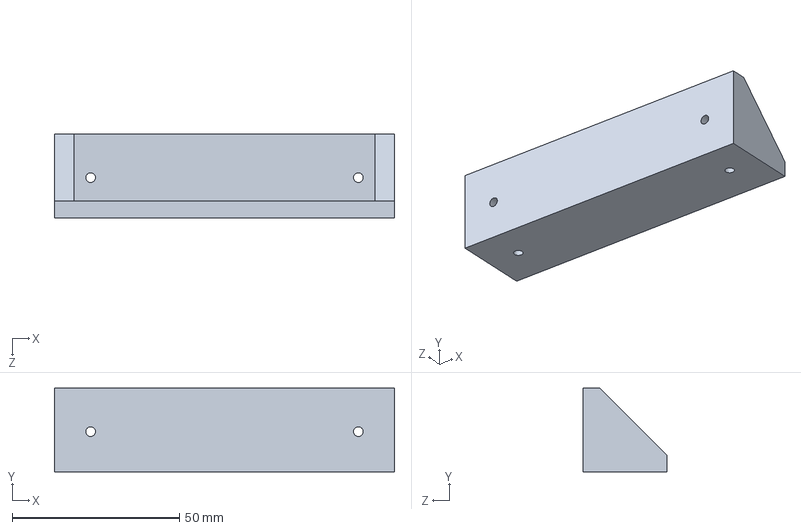
[picture p26: CAD file, 2022-03-23]
CAD/pi_cam/angle_bracket.SLDPRT
101.6 x 25.0 x 25.0 mm
