robmacl/breathecam/CAD/pi_cam/dummy_parts/pelco_eh20.SLDPRT

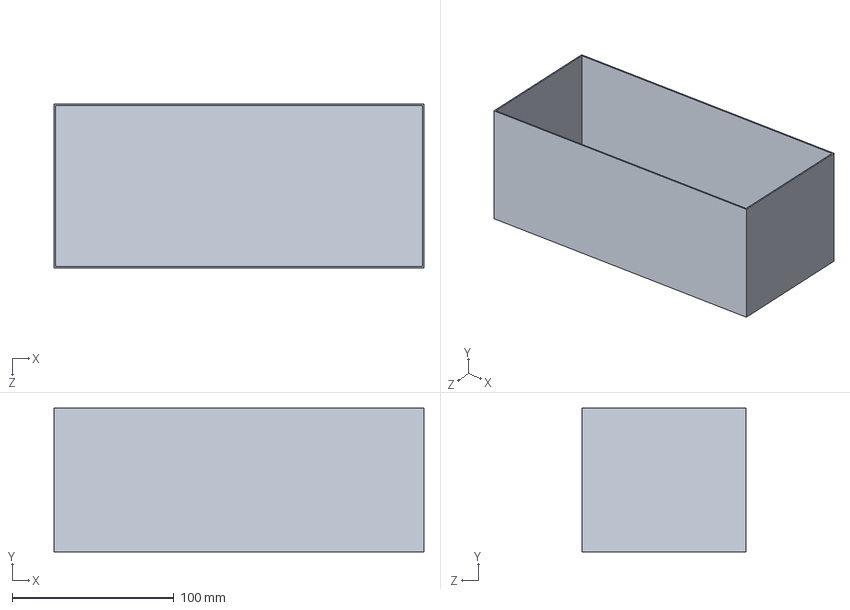
[picture p27: CAD file, 2022-06-23]
CAD/pi_cam/dummy_parts/pelco_eh20.SLDPRT
228.6 x 88.9 x 101.6 mm
