robmacl/breathecam/CAD/nikon/Part3.sldprt

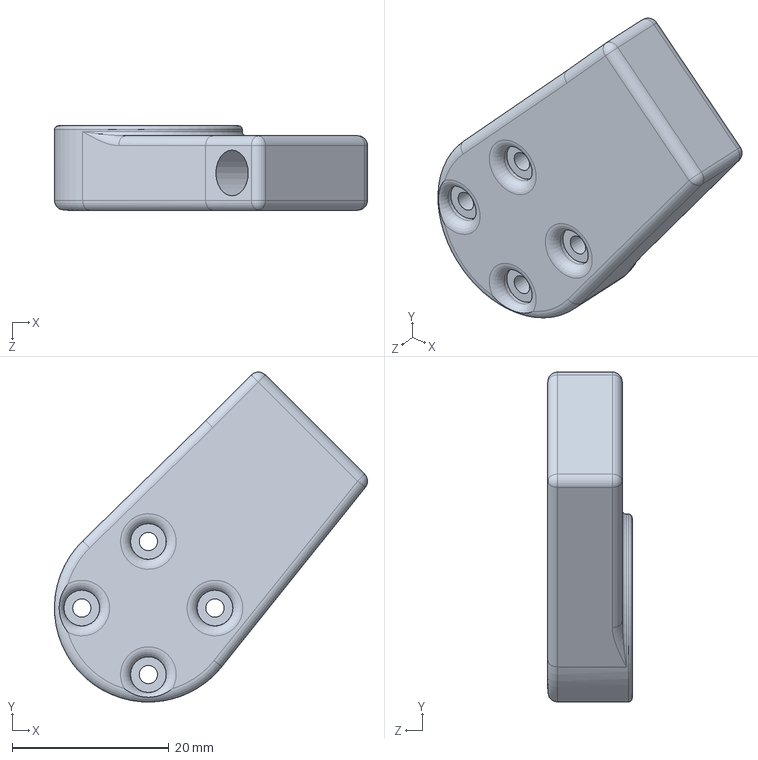
[picture p28: CAD file, 2022-03-16]
CAD/nikon/Part3.sldprt
40.0 x 42.1 x 10.8 mm
