robmacl/breathecam/CAD/pi_cam/dummy_parts/netgear_gs305.SLDPRT

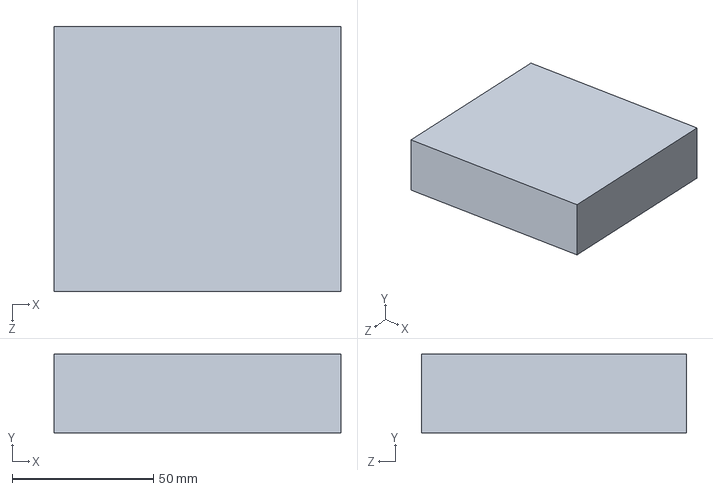
[picture p29: CAD file, 2022-06-23]
CAD/pi_cam/dummy_parts/netgear_gs305.SLDPRT
101.6 x 27.9 x 94.0 mm
