robmacl/breathecam/CAD/nikon/j5 base v4 mini.SLDPRT

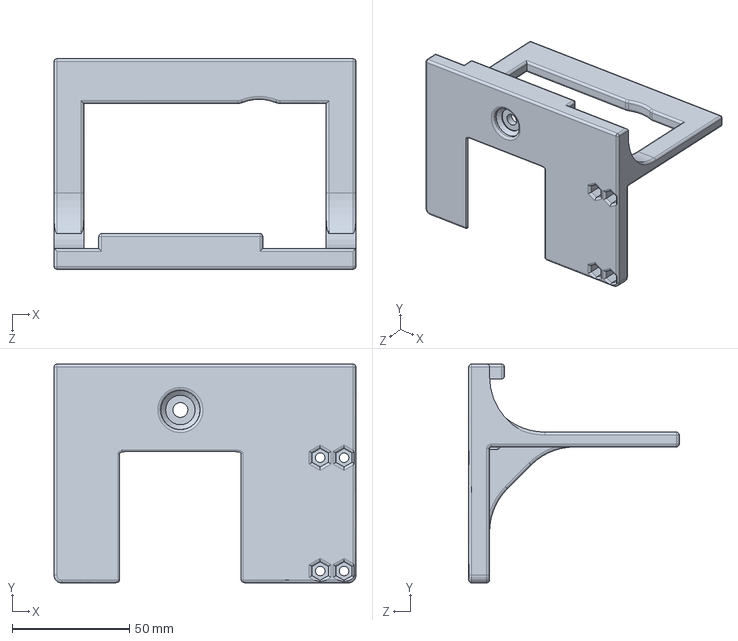
[picture p30: CAD file, 2022-03-16]
CAD/nikon/j5 base v4 mini.SLDPRT
128.6 x 93.2 x 89.7 mm
