robmacl/breathecam/CAD/pi_cam/dummy_parts/UC-698(B0262).STL

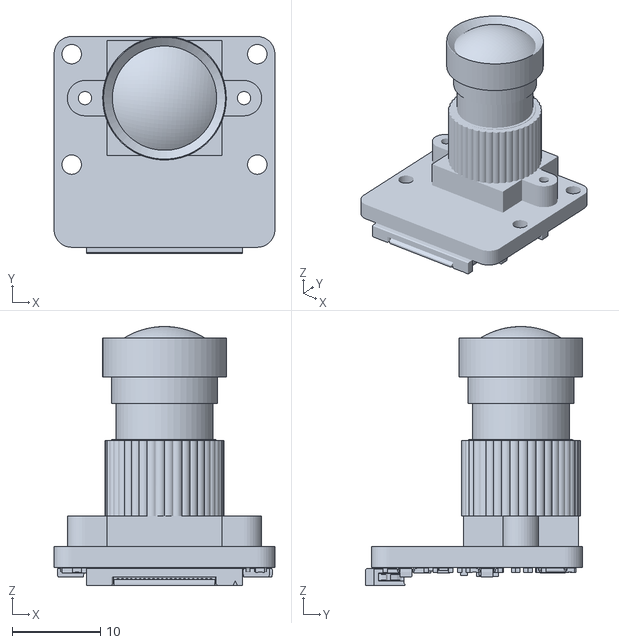
[picture p31: CAD file, 2022-06-23]
CAD/pi_cam/dummy_parts/UC-698(B0262).STL
25.0 x 24.6 x 29.3
