robmacl/breathecam/CAD/nikon/board_v3 - Copy.SLDPRT

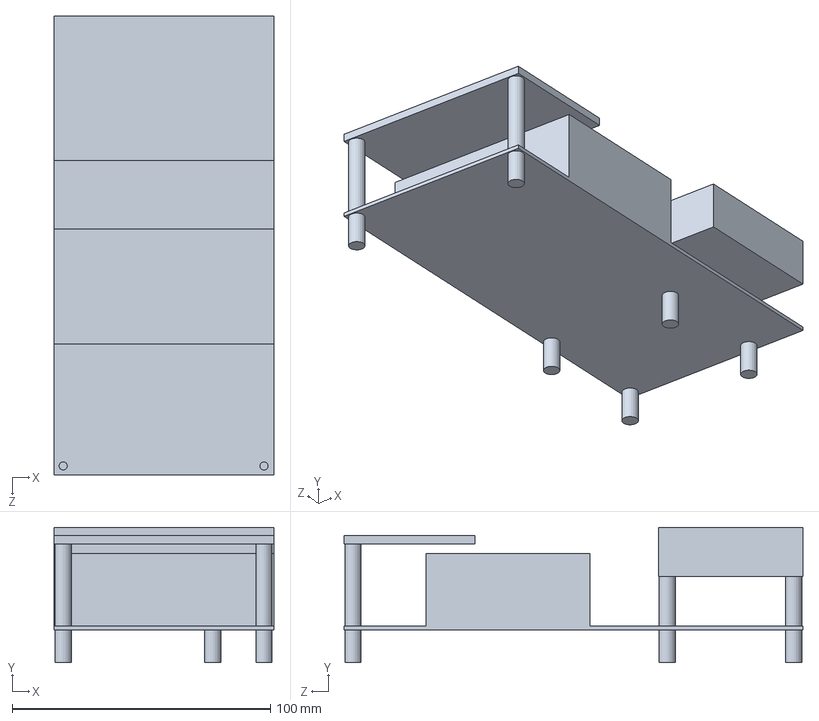
[picture p32: CAD file, 2022-03-16]
CAD/nikon/board_v3 - Copy.SLDPRT
85.1 x 52.3 x 177.8 mm
