robmacl/breathecam/CAD/nikon/ServoHornPlastic.SLDPRT

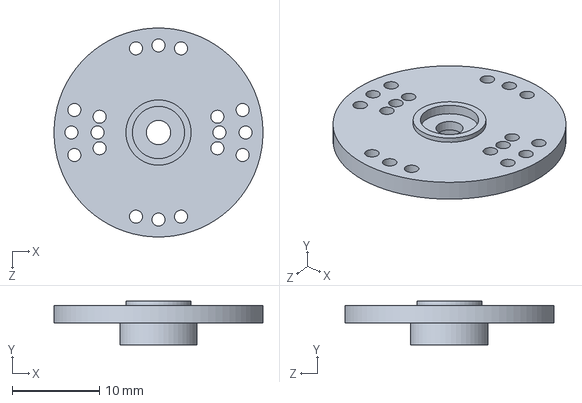
[picture p33: CAD file, 2022-03-16]
CAD/nikon/ServoHornPlastic.SLDPRT
24.0 x 5.00 x 24.0 mm
