robmacl/breathecam/CAD/nikon/servo cover.SLDPRT

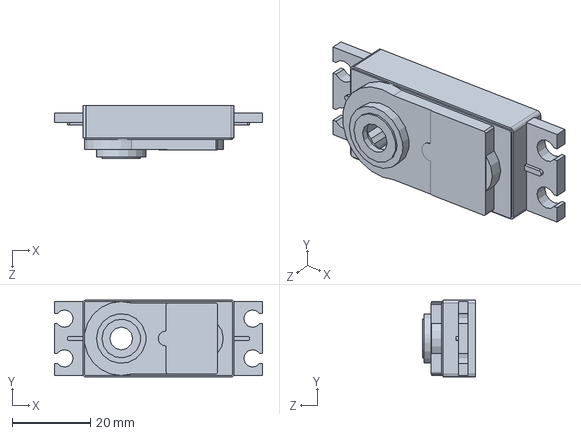
[picture p34: CAD file, 2022-03-16]
CAD/nikon/servo cover.SLDPRT
53.2 x 19.7 x 13.5 mm
