robmacl/breathecam/CAD/nikon/bottom cover.SLDPRT

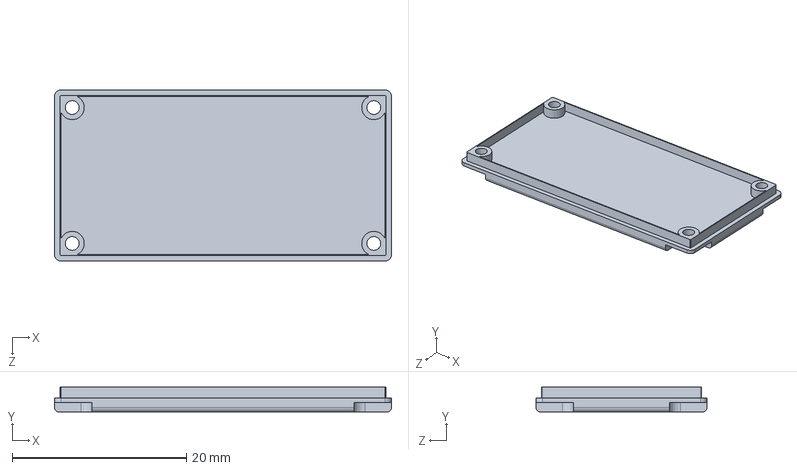
[picture p35: CAD file, 2022-03-16]
CAD/nikon/bottom cover.SLDPRT
38.7 x 2.86 x 19.7 mm
