robmacl/breathecam/CAD/nikon/board_v4.SLDPRT

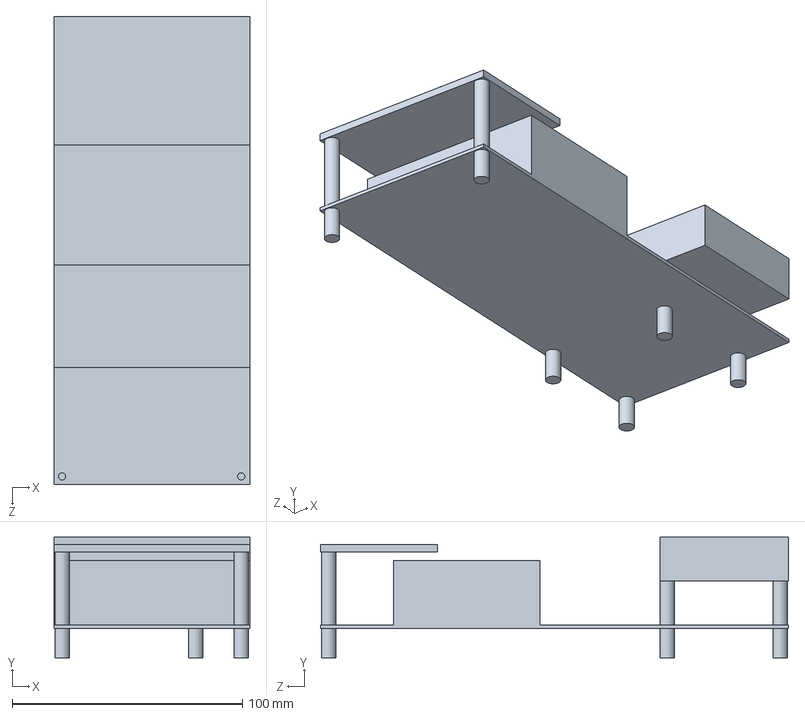
[picture p36: CAD file, 2022-03-16]
CAD/nikon/board_v4.SLDPRT
85.1 x 52.3 x 203.2 mm
