robmacl/breathecam/CAD/nikon/Part5.sldprt

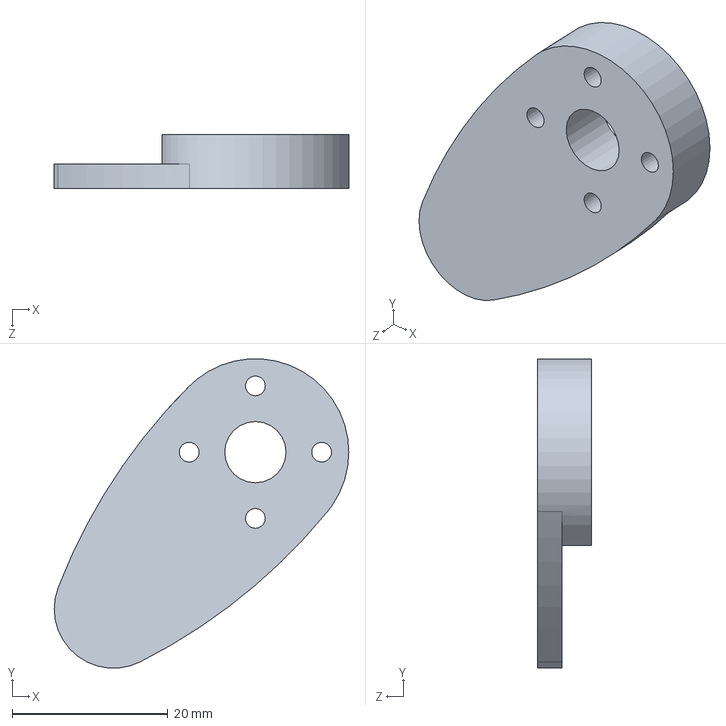
[picture p37: CAD file, 2022-03-16]
CAD/nikon/Part5.sldprt
37.8 x 39.7 x 6.98 mm
