robmacl/breathecam/CAD/nikon/HMSH-01.SLDPRT

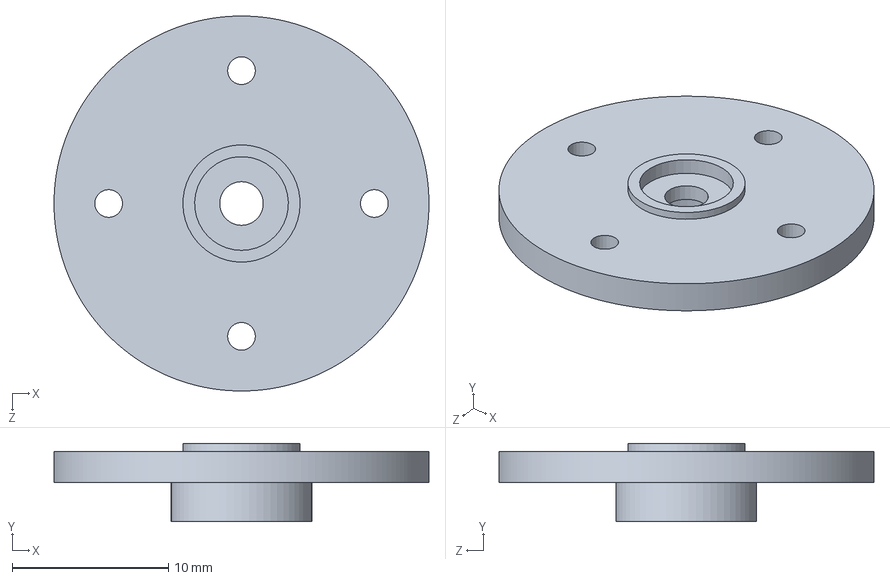
[picture p38: CAD file, 2022-03-16]
CAD/nikon/HMSH-01.SLDPRT
24.0 x 5.00 x 24.0 mm
