robmacl/breathecam/CAD/nikon/standoff_1.5x0.25.SLDPRT

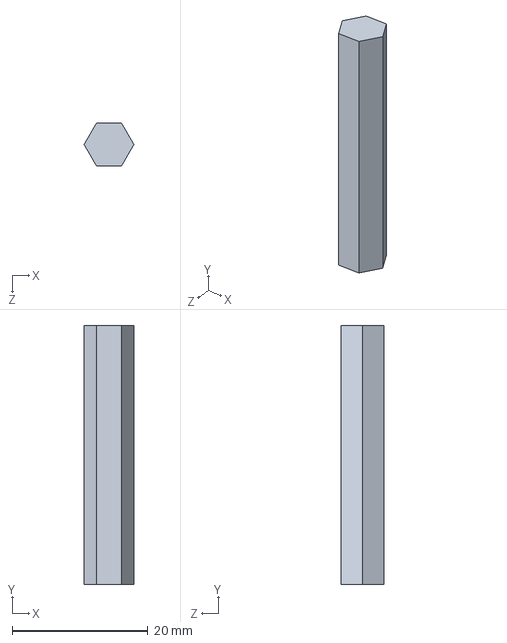
[picture p39: CAD file, 2022-03-16]
CAD/nikon/standoff_1.5x0.25.SLDPRT
7.33 x 38.1 x 6.35 mm
