robmacl/breathecam/CAD/nikon/tie down.SLDPRT

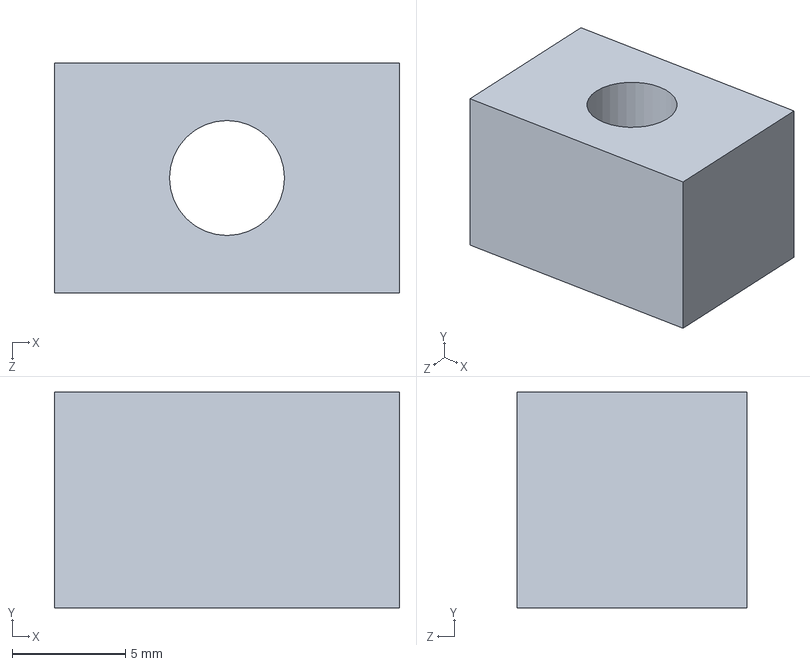
[picture p40: CAD file, 2022-03-16]
CAD/nikon/tie down.SLDPRT
15.2 x 9.53 x 10.2 mm
