robmacl/breathecam/CAD/nikon/spring_return_v1c.SLDPRT

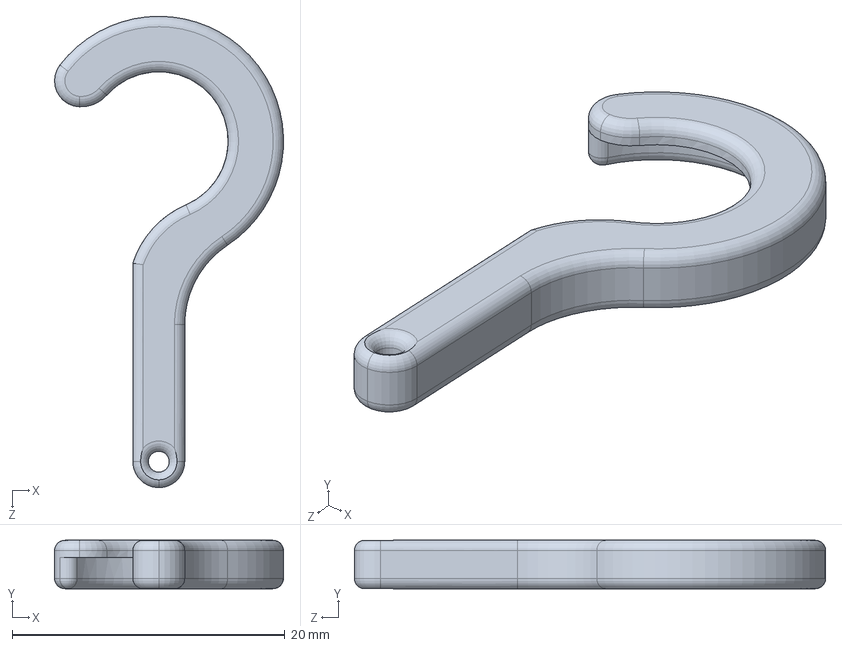
[picture p41: CAD file, 2022-03-16]
CAD/nikon/spring_return_v1c.SLDPRT
16.8 x 3.56 x 34.5 mm
