robmacl/breathecam/CAD/nikon/spring_return_v1b.SLDPRT

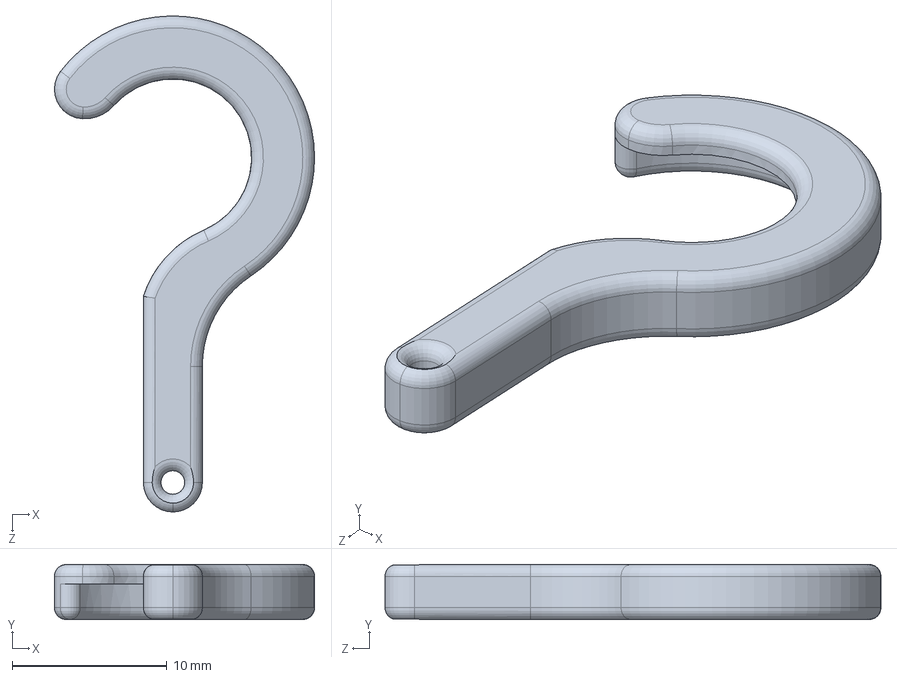
[picture p42: CAD file, 2022-03-16]
CAD/nikon/spring_return_v1b.SLDPRT
16.8 x 3.56 x 32.0 mm
