robmacl/breathecam/CAD/nikon/Part2.sldprt

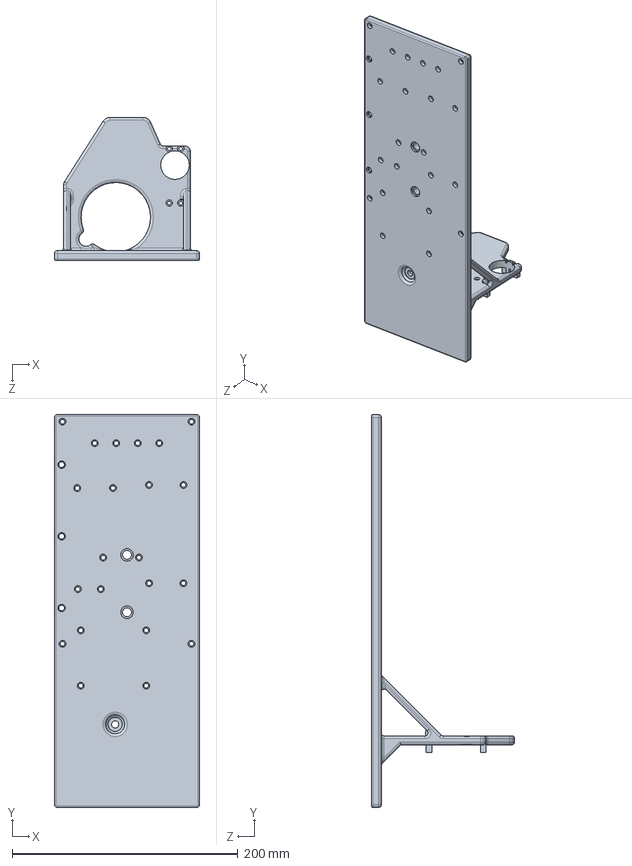
[picture p44: CAD file, 2022-03-16]
CAD/nikon/Part2.sldprt
128.6 x 348.2 x 127.0 mm
