robmacl/breathecam/CAD/nikon/J5 button pusher V2a.SLDPRT

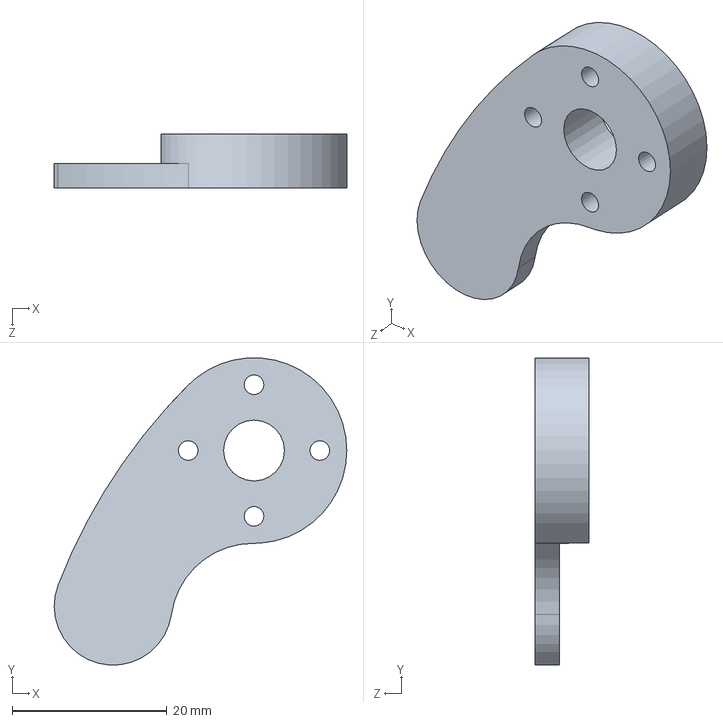
[picture p45: CAD file, 2022-03-16]
CAD/nikon/J5 button pusher V2a.SLDPRT
37.8 x 39.7 x 6.98 mm
