robmacl/breathecam/CAD/nikon/spline output.SLDPRT

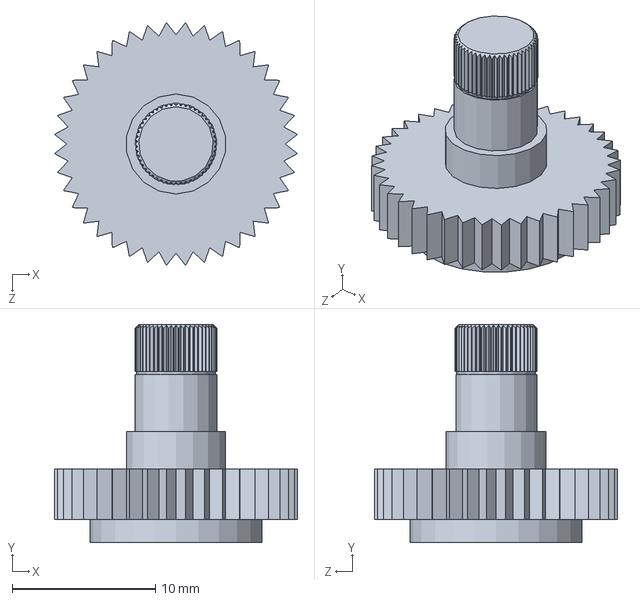
[picture p46: CAD file, 2022-03-16]
CAD/nikon/spline output.SLDPRT
17.0 x 15.2 x 17.0 mm
