robmacl/breathecam/CAD/nikon/camera.SLDPRT

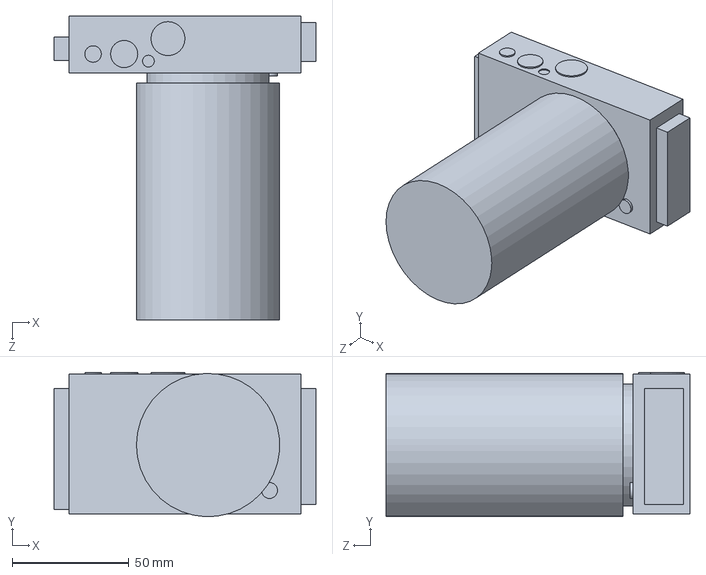
[picture p47: CAD file, 2022-03-16]
CAD/nikon/camera.SLDPRT
112.4 x 61.9 x 130.3 mm
