robmacl/breathecam/(list of files, cad)

Other CAD files:
CAD/pi_cam/dummy_parts/m25_short_rod.SLDPRT
CAD/nikon/j5 base.SLDPRT
CAD/nikon/J5 button pusher V3.SLDPRT
CAD/nikon/J5 button pusher V1.SLDPRT
CAD/nikon/J5 button pusher V2a.STL
CAD/nikon/J5 button pusher V2b.STL
CAD/nikon/J5 button pusher V3.STL
CAD/nikon/Part2.STL
CAD/nikon/Part3.STL
CAD/nikon/ac cover j5.DXF
CAD/nikon/ac cover.DXF
CAD/nikon/camera J5.SLDDRW
CAD/nikon/cover.STL
CAD/nikon/j5 base v1.STL
CAD/nikon/j5 base v2.STL
CAD/nikon/j5 base v3.STL
CAD/nikon/j5 base v4 mini.STL
CAD/nikon/long screw.SLDPRT
CAD/nikon/nut_tester.SLDPRT
CAD/nikon/nut_tester.STL
CAD/nikon/spring_return_v1.SLDPRT
CAD/nikon/spring_return_v1.STL
CAD/nikon/spring_return_v1b.STL
CAD/nikon/spring_return_v1c.STL
CAD/nikon/spring_return_v2.STL
CAD/pi_cam/dummy_parts/90368A102_18-8 Stainless Steel Knurled-Head Thumb Nut.SLDPRT
CAD/pi_cam/dummy_parts/92319A118_Nylon 6 6 Plastic Hex Standoff.SLDPRT
CAD/pi_cam/dummy_parts/93625A102_18-8 Stainless Steel Nylon-Insert Locknut.SLDPRT
CAD/pi_cam/dummy_parts/93657A224_Nylon Unthreaded Spacer.SLDPRT
CAD/pi_cam/dummy_parts/93800A114_Nylon Hex Nut.SLDPRT
CAD/pi_cam/dummy_parts/94180A323_Tapered Heat-Set Inserts for Plastic(1).SLDPRT
CAD/pi_cam/dummy_parts/94180A323_Tapered Heat-Set Inserts for Plastic.SLDPRT
CAD/pi_cam/dummy_parts/94180A333_Tapered Heat-Set Inserts for Plastic.SLDPRT
CAD/pi_cam/dummy_parts/95610A011_Nylon Plastic Washer.SLDPRT
CAD/pi_cam/dummy_parts/BFB03505HHA-A.stp
