robmacl/breathecam/Misc/Nikon/install gphoto from source.rtf

sudo apt-get update
apt-get upgrade

- install gphoto
> sudo apt-get install gphoto2
> gphoto2 -v

gphoto2 2.5.4 gcc, popt(m), exif, cdk, aa, jpeg, readline
libgphoto2 2.5.4 all camlibs, gcc, ltdl, EXIF
libgphoto2_port 0.10.0 gcc, ltdl, no USB, serial without locking

- update gphoto
> cd ~/nikon/
> chmod +x gphoto2-updater.sh
> sudo ./gphoto2-updater.sh (install most stable (2.5.10))

check /etc/ld.so.conf for "include /usr/local/lib"
if not, then add it, and run "sudo ldconfig"

- check to make sure gphoto version is good
> gphoto2 -v

gphoto2 2.5.10 gcc, popt(m), exif, no cdk, no aa, no jpeg, no readline
libgphoto2 2.5.10 all camlibs, gcc, ltdl, EXIF
libgphoto2_port 0.12.0 gcc, ltdl, USB, serial without locking

cd gphoto2-2.5.10_CUSTOM/

make
sudo make install
cd ..

sudo ldconfig

*********************************************
http://www.ohmypi.com/category/libusb/
sudo apt-get update
apt-get upgrade
sudo apt-get install -y libltdl-dev libusb-dev libexif-dev libpopt-dev
mkdir gphoto-working-directory
cd gphoto-working-directory/

cd libusbx-1.0.11/
./configure
make
sudo make install
cd ..

cd libgphoto2-2.5.10/
./configure
make
sudo make install
cd ..

cd gphoto2-2.5.10/
./configure
make
sudo make install
cd ..

sudo ldconfig

sudo apt-get install subversion
sudo apt-get install dh-autoreconf
sudo apt-get install automake
sudo apt-get install autoconf
sudo apt-get install libtool
sudo apt-get install gettext
sudo apt-get install pkg-config

libexif, libusb, libgphoto2, gphoto2, and gtkam.

svn checkout https://gphoto.svn.sourceforge.net/svnroot/gphoto/trunk/gphoto-suite

cd gphoto-suite/
autoreconf --install --symlink
