robmacl/breathecam/Misc/Nikon/install gphoto2.rtf

$ sudo apt-get install automake autoconf libtool autopoint pkg-config subversion libusb-dev libpopt-dev gettext build-essential libglib2.0-dev

$ svn checkout svn://svn.code.sf.net/p/gphoto/code/trunk gphoto

$ cd gphoto/libgphoto2/
$ autoreconf --install --symlink
$ ./configure
$ make
$ sudo make install

$ cd ../gphoto2
$ autoreconf --install --symlink
$ ./configure
$ make
$ sudo make install

$ LD_LIBRARY_PATH=/usr/local/lib /usr/local/bin/gphoto2 --version
