robmacl/breathecam/Schematics/Nikon_PowerBoardV3.brd

## EAGLE design Schematics/Nikon_PowerBoardV3.brd (2022-03-16, an earlier design)

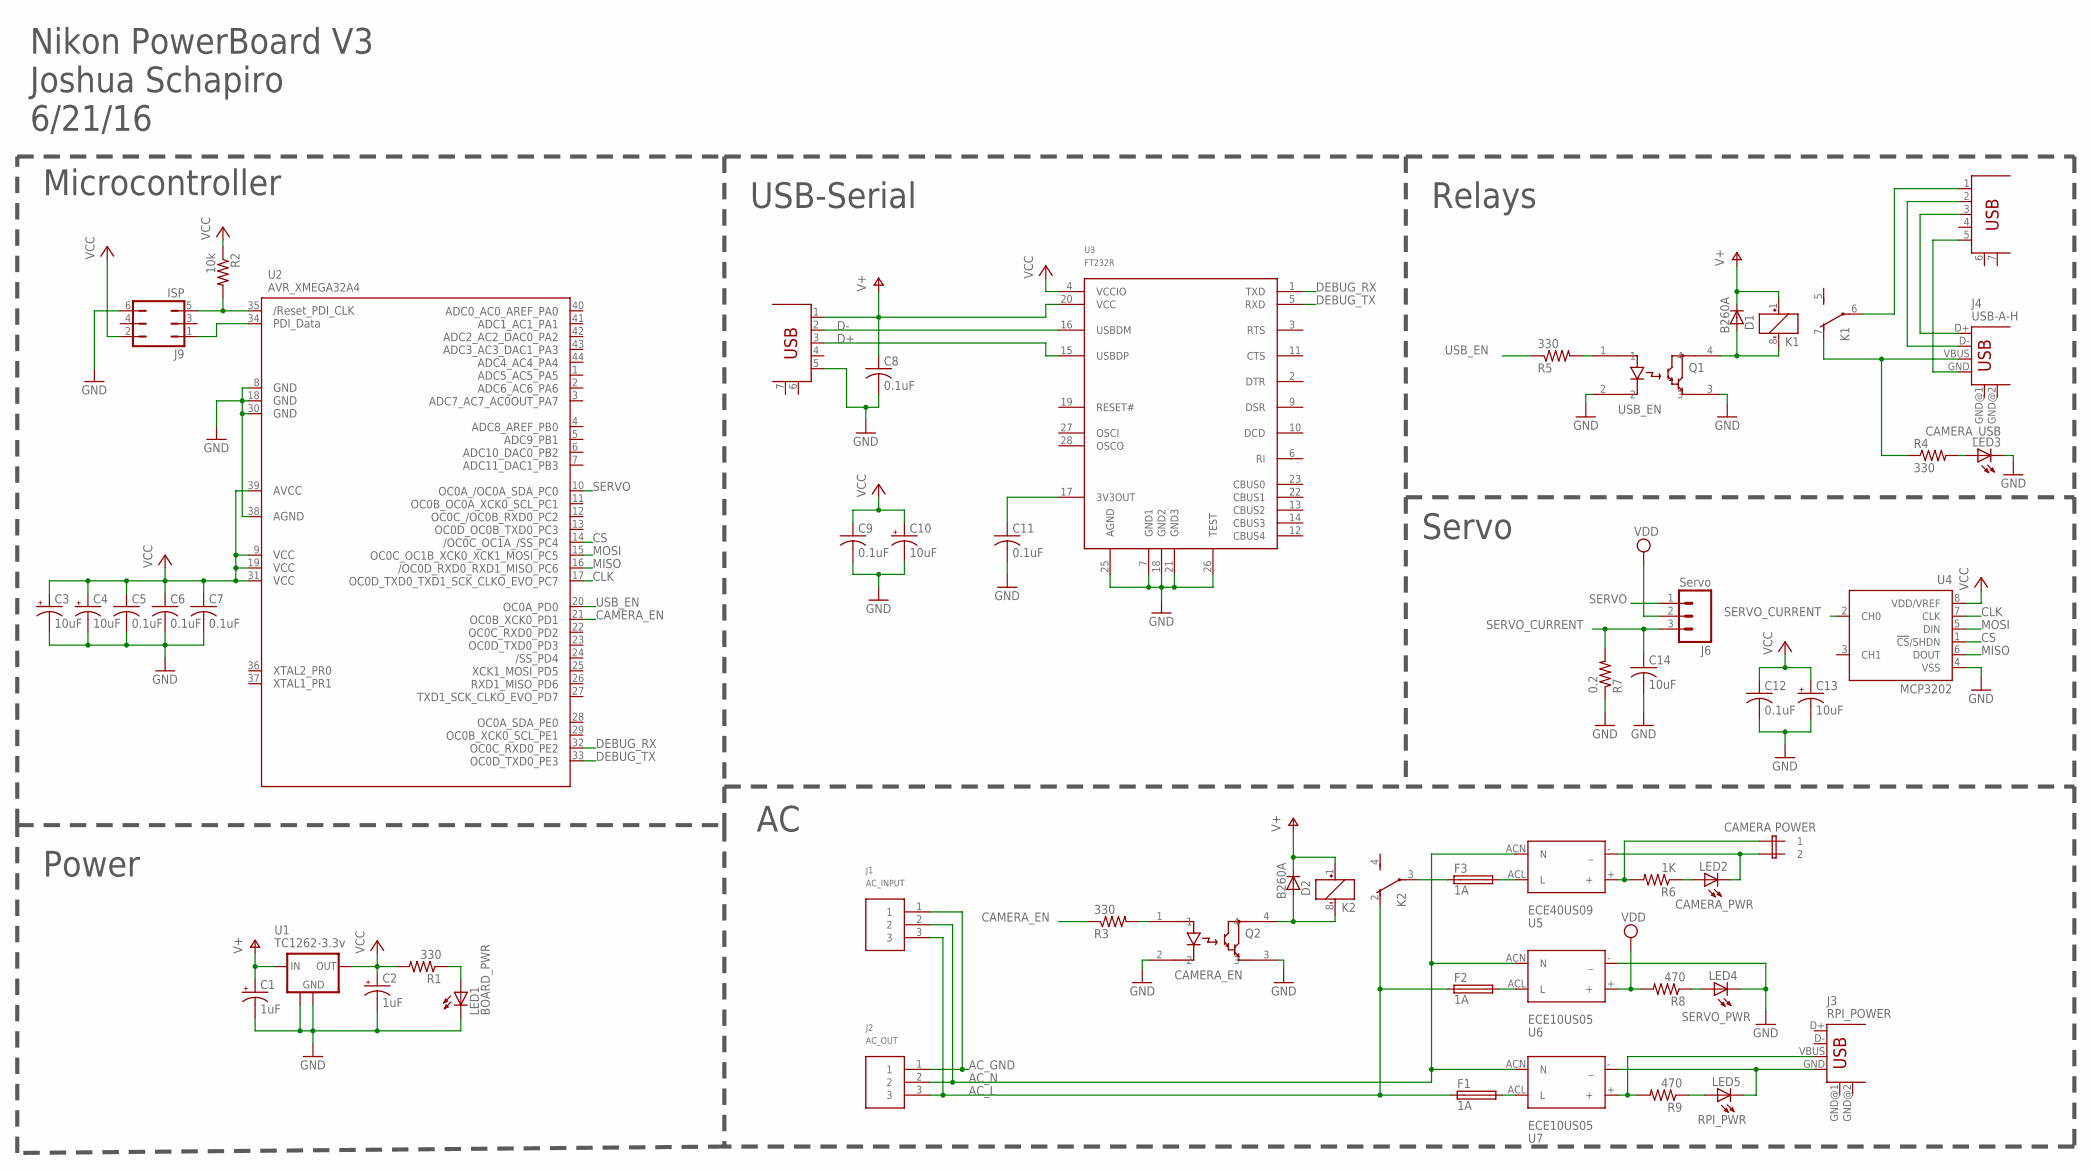
[picture p48: schematic Nikon_PowerBoardV3.sch]

Parts:
C1, C2: 1uF; EIA3216
C3, C4, C10, C13: 10uF; EIA3216
C5, C6, C7, C8, C9, C11, C12: 0.1uF; C0603
C14: 10uF; C1206
D1, D2: B260A; SMA-DIODE
F1, F2, F3: 1A; 19560
J1: AC_INPUT; 3-PIN-SCREW
J2: AC_OUT; 3-PIN-SCREW
J3: RPI_POWER; USB-A-H
J4: USB-A-H
J5: CAMERA POWER; 2-PIN_SCREWTERM
J6: Servo; 1X03_LONGPADS
J7, J8: MICRO-USB; MICRO_USB_SM_W/_TO_PINS
J9: ISP; JP3Q
K1: USB_EN; G6K-2F
K2: CAMERA_EN; G6K-2F
LED1: BOARD_PWR; CHIPLED_0603
LED2: CAMERA_PWR; CHIPLED_0603
LED3: CAMERA_USB; CHIPLED_0603
LED4: SERVO_PWR; CHIPLED_0603
LED5: RPI_PWR; CHIPLED_0603
Q1: USB_EN; 4-PIN_MINI-FLAT
Q2: CAMERA_EN; 4-PIN_MINI-FLAT
R1, R3, R4, R5: 330; R0603
R2: 10k; R0603
R6: 1K; R0603
R7: 0.2; R1206
R8, R9: 470; R0603
U1: TC1262-3.3v; SOT223
U2: AVR_XMEGA32A4; TQFP44
U3: FT232R; SSOP28
U4: MCP3202; SO-08
U5: ECE40US09; EC40
U6, U7: ECE10US05; ECE10

Connections:
AC_GND: J1.1, J2.1
AC_L: F1.1, F2.1, J1.3, J2.3, K2.2 (O)
AC_N: J1.2, J2.2, U5.ACN (N), U6.ACN (N), U7.ACN (N)
CAMERA_EN: R3.1, U2.21 (PD1)
CLK: U2.17 (PC7), U4.7 (CLK)
CS: U2.14 (PC4), U4.1 (!CS!/SHDN)
D+: J8.3 (D+), U3.15 (USBDP)
D-: J8.2 (D-), U3.16 (USBDM)
DEBUG_RX: U2.32 (PE2), U3.1 (TXD)
DEBUG_TX: U2.33 (PE3), U3.5 (RXD)
GND: C1.C (-), C2.C (-), C3.C (-), C4.C (-), C5.2, C6.2, C7.2, C8.2, C9.2, C10.C (-), C11.2, C12.2, C13.C (-), C14.2, J8.5 (GND), J9.6, LED1.C, LED3.C, LED4.C, Q1.2, Q1.3, Q2.2, Q2.3, R7.1, U1.2 (GND), U1.4 (GND1), U2.8 (GND1), U2.18 (GND2), U2.30 (GND3), U2.38 (AGND), U3.7 (GND1), U3.18 (GND2), U3.21 (GND3), U3.25 (AGND), U3.26 (TEST), U4.4 (VSS), U6.- (_)
MISO: U2.16 (PC6), U4.6 (DOUT)
MOSI: U2.15 (PC5), U4.5 (DIN)
unnamed: J9.1, U2.34 (PDI_DATA)
unnamed: J4.GND, J7.5 (GND)
unnamed: F3.1, K2.3
unnamed: LED1.A, R1.1
unnamed: Q1.1, R5.2
unnamed: J9.5, R2.2, U2.35 (RESET)
unnamed: D2.A, K2.8 (-), Q2.4
unnamed: J7.1 (VBUS), K1.6
unnamed: LED3.A, R4.2
unnamed: Q2.1, R3.2
unnamed: J3.VBUS, R9.2, U7.+
unnamed: F3.2, U5.ACL (L)
unnamed: F2.2, U6.ACL (L)
unnamed: F1.2, U7.ACL (L)
unnamed: LED4.A, R8.1
unnamed: J5.P$1 (1), R6.2, U5.+
unnamed: C11.1, U3.17 (3V3OUT)
unnamed: LED2.A, R6.1
unnamed: J5.P$2 (2), LED2.C, U5.- (_)
unnamed: J3.GND, LED5.C, U7.- (_)
unnamed: LED5.A, R9.1
unnamed: J4.VBUS, K1.7 (O), R4.1
unnamed: J4.D+, J7.3 (D+)
unnamed: J4.D-, J7.2 (D-)
unnamed: D1.A, K1.8 (-), Q1.4
SERVO: J6.1, U2.10 (PC0)
SERVO_CURRENT: C14.1, J6.3, R7.2, U4.2 (CH0)
USB_EN: R5.1, U2.20 (PD0)
V+: C1.A (+), C8.1, D1.C, D2.C, J8.1 (VBUS), K1.1 (+), K2.1 (+), U1.1 (IN), U3.20 (VCC)
VCC: C2.A (+), C3.A (+), C4.A (+), C5.1, C6.1, C7.1, C9.1, C10.A (+), C12.1, C13.A (+), J9.2, R1.2, R2.1, U1.3 (OUT), U2.9 (VCC1), U2.19 (VCC2), U2.31 (VCC3), U2.39 (AVCC), U3.4 (VCCIO), U4.8 (VDD/VREF)
VDD: J6.2, R8.2, U6.+

Notes on the sheet:
Nikon PowerBoard V3 Joshua Schapiro 6/21/16
Microcontroller
USB-Serial
Relays
Power
Servo
CAMERA POWER

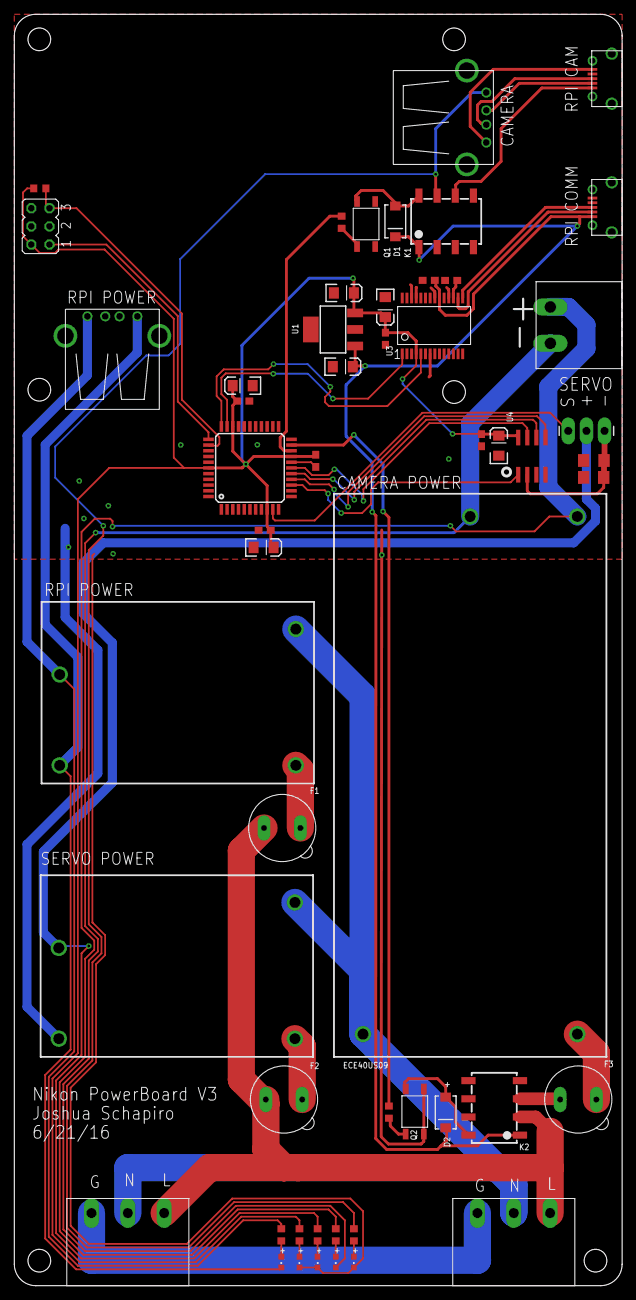
[picture p49: board Nikon_PowerBoardV3.brd from above]

Board: 2 copper layers, 85.0 x 177.8 mm, 53 parts (0 on the bottom side), 44 nets.
