robmacl/breathecam/Schematics/Nikon_PowerBoardV1.brd

## EAGLE design Schematics/Nikon_PowerBoardV1.brd (2022-03-16, an earlier design)

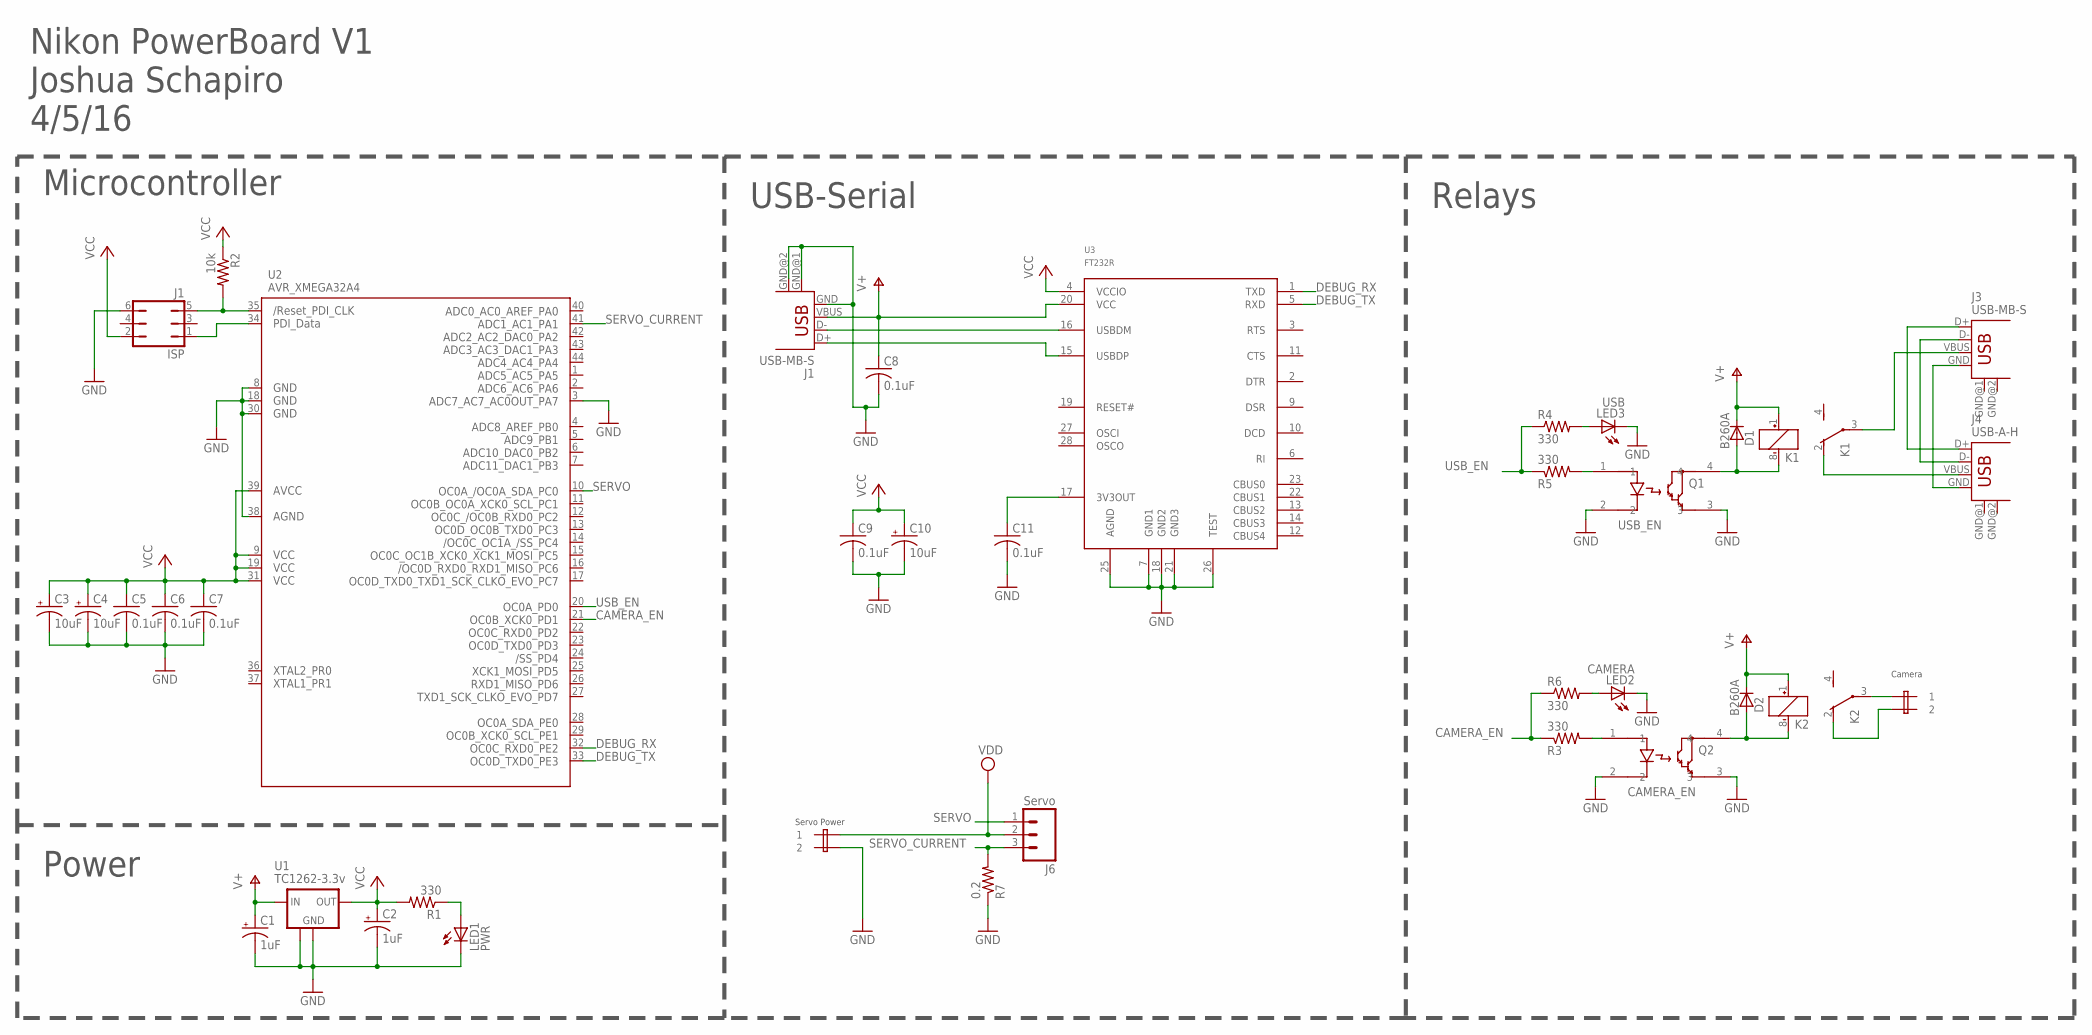
[picture p50: schematic Nikon_PowerBoardV1.sch]

Parts:
C1, C2: 1uF; EIA3216
C3, C4, C10: 10uF; EIA3216
C5, C6, C7, C8, C9, C11: 0.1uF; C1206
D1, D2: B260A; SMA-DIODE
ISP: J1; JP3Q
J1, J3: USB-MB-S
J2: Camera; 2-PIN_SCREWTERM
J4: USB-A-H
J5: ServoPower; 2-PIN_SCREWTERM
J6: Servo; 1X03_LONGPADS
K1: USB_EN; G6K-2F
K2: CAMERA_EN; G6K-2F
LED1: PWR; CHIPLED_1206
LED2: CAMERA; CHIPLED_1206
LED3: USB; CHIPLED_1206
Q1: USB_EN; 4-PIN_MINI-FLAT
Q2: CAMERA_EN; 4-PIN_MINI-FLAT
R1, R3, R4, R5, R6: 330; R1206
R2: 10k; R1206
R7: 0.2; R1206
U1: TC1262-3.3v; SOT223
U2: AVR_XMEGA32A4; TQFP44
U3: FT232R; SSOP28

Connections:
CAMERA_EN: R3.1, R6.1, U2.21 (PD1)
DEBUG_RX: U2.32 (PE2), U3.1 (TXD)
DEBUG_TX: U2.33 (PE3), U3.5 (RXD)
GND: C1.C (-), C2.C (-), C3.C (-), C4.C (-), C5.2, C6.2, C7.2, C8.2, C9.2, C10.C (-), C11.2, ISP.6, J1.GND, J1.GND@1 (GND), J1.GND@2 (GND), J5.P$2 (2), LED1.C, LED2.C, LED3.C, Q1.2, Q1.3, Q2.2, Q2.3, R7.1, U1.2 (GND), U1.4 (GND1), U2.3 (PA7), U2.8 (GND1), U2.18 (GND2), U2.30 (GND3), U2.38 (AGND), U3.7 (GND1), U3.18 (GND2), U3.21 (GND3), U3.25 (AGND), U3.26 (TEST)
J2: J3.D+, J4.D+
unnamed: ISP.1, U2.34 (PDI_DATA)
unnamed: J3.GND, J4.GND
unnamed: J3.D-, J4.D-
unnamed: LED1.A, R1.1
unnamed: Q1.1, R5.2
unnamed: ISP.5, R2.2, U2.35 (RESET)
unnamed: D2.A, K2.8 (-), Q2.4
unnamed: J3.VBUS, K1.3
unnamed: J4.VBUS, K1.2 (O)
unnamed: LED3.A, R4.2
unnamed: Q2.1, R3.2
unnamed: J1.D-, U3.16 (USBDM)
unnamed: J1.D+, U3.15 (USBDP)
unnamed: J2.P$1 (1), K2.3
unnamed: J2.P$2 (2), K2.2 (O)
unnamed: C11.1, U3.17 (3V3OUT)
unnamed: LED2.A, R6.2
unnamed: D1.A, K1.8 (-), Q1.4
SERVO: J6.1, U2.10 (PC0)
SERVO_CURRENT: J6.3, R7.2, U2.41 (PA1)
USB_EN: R4.1, R5.1, U2.20 (PD0)
V+: C1.A (+), C8.1, D1.C, D2.C, J1.VBUS, K1.1 (+), K2.1 (+), U1.1 (IN), U3.20 (VCC)
VCC: C2.A (+), C3.A (+), C4.A (+), C5.1, C6.1, C7.1, C9.1, C10.A (+), ISP.2, R1.2, R2.1, U1.3 (OUT), U2.9 (VCC1), U2.19 (VCC2), U2.31 (VCC3), U2.39 (AVCC), U3.4 (VCCIO)
VDD: J5.P$1 (1), J6.2

Notes on the sheet:
Camera
Nikon PowerBoard V1 Joshua Schapiro 4/5/16
Microcontroller
USB-Serial
Relays
Power
Servo Power

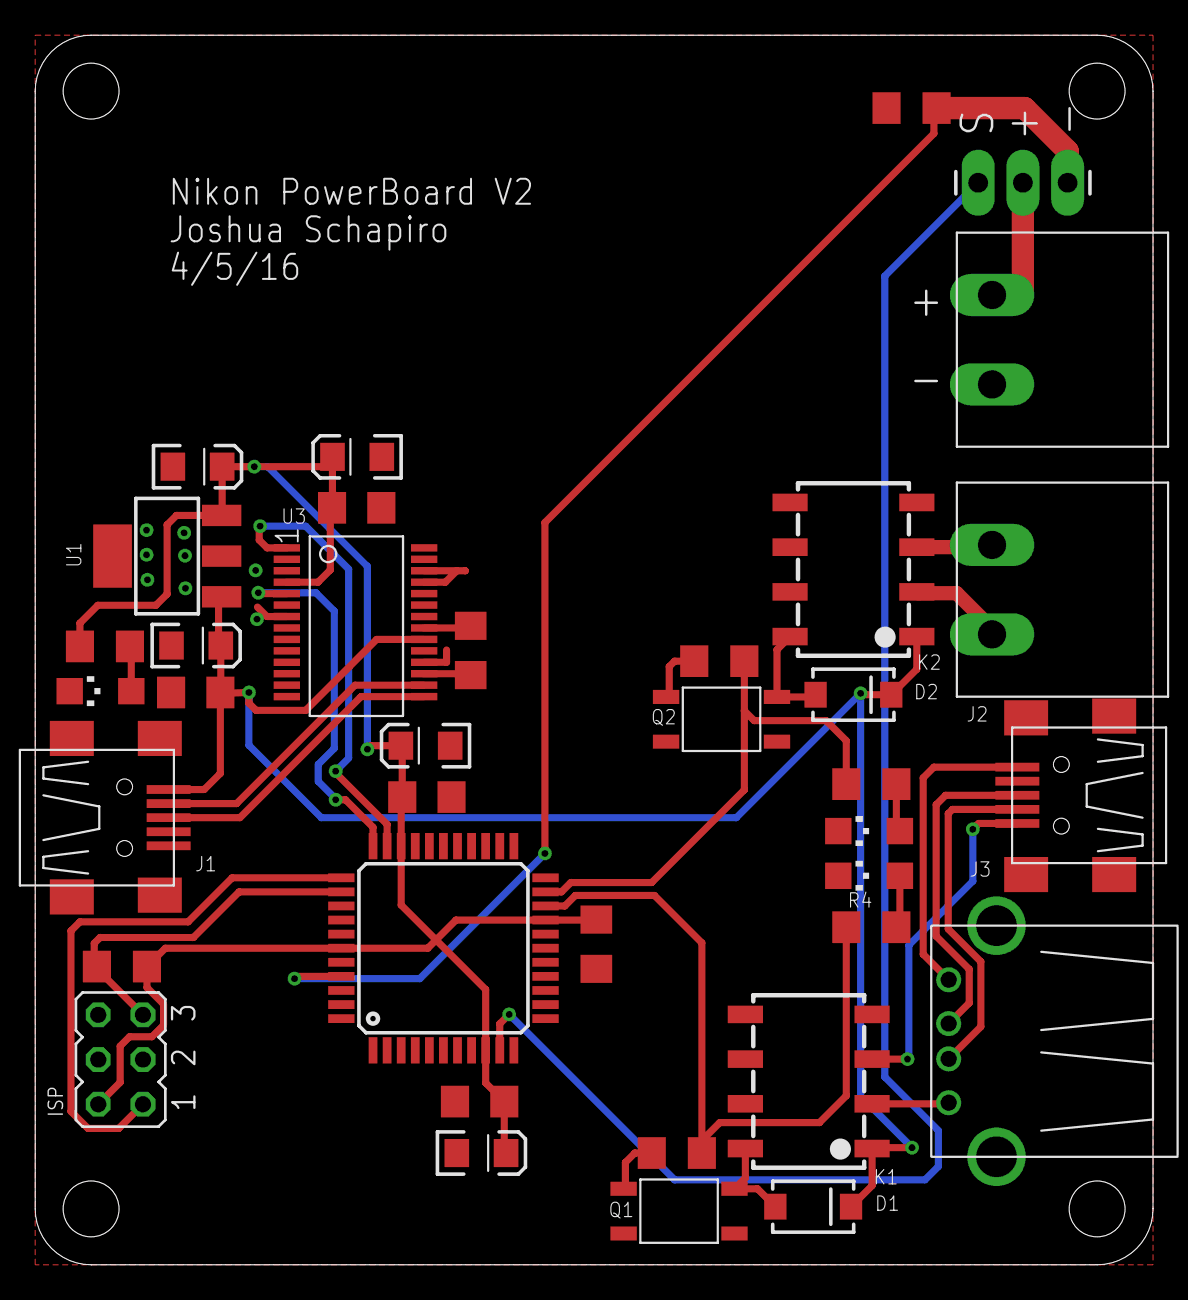
[picture p51: board Nikon_PowerBoardV1.brd from above]

Board: 2 copper layers, 63.5 x 69.8 mm, 37 parts (0 on the bottom side), 29 nets.
