robmacl/breathecam/(commit log)

2022-03-16 Code and design files for BreatheCam cameras.
    [Assem1.SLDASM, Assem_j5.SLDASM, HMSH-01.SLDPRT, J5 button pusher V1.SLDPRT, J5 button pusher V2a.SLDPRT, J5 button pusher V2a.STL, J5 button pusher V2b.SLDPRT, J5 button pusher V2b.STL]
2022-03-23 Deleted old image of the 'requests' package in nikon/install/requests, added new CAD files in CAD/pi_cam
    [95947A009_Aluminum Female Threaded Hex Standoff.SLDPRT, angle_bracket.SLDPRT, camera_mount.SLDPRT, mount_plate.SLDPRT]
2022-04-05 Modified camera_mount.SLDPRT to allow access to focus lock screw using hex key. Fixed the mounting slots in mount_plate.SLDPRT some more.
    [camera_mount.SLDPRT, mount_plate.SLDPRT]
2022-04-06 Various changes to improve fit of the mount within the housing. Also added stiffeners to the plate and incorporated the standoffs into the plate.
    [camera_mount.SLDPRT, mount_plate.SLDPRT]
2022-04-09 Made some test parts for tweaking mounting hole sizes, and moved the mount slots so we are 5mm farther back.
    [drill_test.SLDPRT, insert_test.SLDPRT, mount_plate.SLDPRT]
2022-04-14 More tweaks to CAD/pi_cam related to integral standoff holes and front relief for cameras (mainly to improve front side access to lens).
    [94180A323_Tapered Heat-Set Inserts for Plastic.SLDPRT, camera_mount.SLDPRT, insert_test.SLDPRT, mount_plate.SLDPRT]
2022-04-26 Resurrected ping processes, changed to .ini style config file. Log entries now have the service name. Tweaked logging usage so that a useful amount of info is present at the INFO level.
    takeImage_launcher.sh ==> imageService_launcher.sh
    run_all.sh (new)
    Launch all the launchers
    kill_all.sh: (new)
    Kill all the processes by name using pkill
    config_files/breathecam.ini (new)
    config_files/id.txt (deleted)
    config_files/pingserver.txt (deleted)
    config_files/server.txt (deleted):
    New .ini format config file, get rid of the old ones.
    Changes not staged for commit:
    (use "git add/rm <file>..." to update what will be committed)
    (use "git checkout -- <file>..." to discard changes i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
2022-05-04 Minor changes to startup scripts and error code
    [imageService.py, pingServer.py, uploadToServer.py]
2022-05-18 Fixes to startup scripts and watchdog feature. Now startup at reboot is working.
    Code/pi_cam/imageService.py:
    Documentation for grab_cmd, add --rotation 180 for test camera
    Code/pi_cam/pingServer.py:
    -- Make named parameters for watchdog parameters
    -- Reckon image age from the oldest image since last ping failure. This
    avoids a spurious watchdog message on startup.
    -- More comments on watchdog operation
    Code/pi_cam/pingServer_launcher.sh
    Code/pi_cam/run_all.sh:
    Changed to use "su" to change from root rather than "runuser". This seems to
    actually work in the cron @reboot context.
    [imageService.py, pingServer.py]
2022-05-18 More tweaks to watchdog and reboot function. Now actually working reliably?
    Revert change to not count old image files for age, and if no files, treat as
    very old. We want to fail if at start capture is already failing, and if
    there are no files at all. Reduced watchdog_threshold from 10 to 5 and
    age_threshold from 120 to 60. I don't think there is much point in delaying
    reboot more than that.
    Code/pi_cam/pingServer_launcher.sh:
    More reboot debugging code.
    Removed /tmp/run_test logging
    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
    [pingServer.py]
2022-05-20 moved camera parameters to config file
2022-06-07 Multi-camera support with Arducam multiplexer.
    Code/pi_cam/config_files/breathecam.ini:
    Update for "piquad" multi-camera setup.
    Code/pi_cam/serviceConfig.py:
    Camera mux support. Got rid of some camera parameter caching in serviceConfig
    Handle the <time>_<cam number>.jpg file format. Watchdog does not yet
    recognize if we are only missing some of the cameras.
    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
    [boot_config.txt]
2022-06-23 Start mechanical work on 4 rPi camera
    [92319A118_Nylon 6 6 Plastic Hex Standoff.SLDPRT, 93625A102_18-8 Stainless Steel Nylon-Insert Locknut.SLDPRT, 93657A224_Nylon Unthreaded Spacer.SLDPRT, 93800A114_Nylon Hex Nut.SLDPRT, 94180A323_Tapered Heat-Set Inserts for Plastic.SLDPRT, 95610A011_Nylon Plastic Washer.SLDPRT, 95947A009_Aluminum Female Threaded Hex Standoff.SLDPRT, Raspberry Pi 4 Model B.SLDASM]
2022-06-27 For quad pi mechanical design, revised holder setup for card cage, added cooling air components.
    [90368A102_18-8 Stainless Steel Knurled-Head Thumb Nut.SLDPRT, 94180A323_Tapered Heat-Set Inserts for Plastic(1).SLDPRT, BFB03505HHA-A.stp, air_box.SLDPRT, air_top.SLDPRT, camera_mount.SLDPRT, m25_clamp_rod.SLDPRT, m25_long_rod.SLDPRT]
2022-07-11 A lot of fiddling with the snap clip design on air_top.SLDPRT and refactoring of the relations between the air_XXX and the other bits of the assembly.
    [94180A333_Tapered Heat-Set Inserts for Plastic.SLDPRT, air_box.SLDPRT, air_top.SLDPRT, mount_plate_4pi.SLDPRT, retainer_clamp_4pii.SLDPRT]
2022-07-13 Tweaks to air_box, air_top increasing thickness back to 1.6mm, since the 1.2mm was printing unreliably and pretty flimsy. Added fillets. On camera_mount_assy_4pi, removed the clamp bosses, moved the 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
    [air_box.SLDPRT, air_top.SLDPRT, mount_plate_4pi.SLDPRT]
2022-07-15 Updatess to CAD/pi_cam. Added stiffeners to mount_plate_4pi.SLDPRT and chamfer the mount keyholes. Add compliant blower mount to air_top.SLDPRT for vibration reduction. Thin air_box.SLDPRT to make th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
    [air_box.SLDPRT, air_top.SLDPRT, fan_assy.SLDASM, mount_plate_4pi.SLDPRT]
2022-07-18 Tweaks to mount_plate_4pi.SLDPRT to increase stiffness and improve the alignment of the slots with the enclosure.
    [mount_plate_4pi.SLDPRT]
2022-07-26 New power_mount.SLDPRT for holding Ethernet switch and power supply. Tweaks to camera_mount.SLDPRT intended to reduce warping, less material in the mount flange, stiffener ribs on the front.
    [camera_mount.SLDPRT, power_mount.SLDPRT]
